fcte-pi1/2026.2_PI1_Grupo1_Lui/README.md

# Projeto Integrador 1 - 2026.2 | Grupo 01 | Prof. Lui

<div align="center">
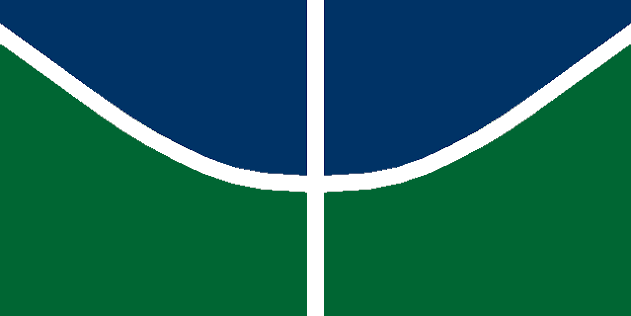
[picture p1: docs/images.png]
Logo UnB
  

  # Projeto Integrador 1 — Micromouse (Grupo 1)
  **Semestre 2026.2 | Universidade de Brasília (UnB) | Prof. Lui**

  
</div>

---

> **Aviso ao Professor:** Este é o repositório oficial do Grupo 01 utilizado para o desenvolvimento do projeto de PI1 (Micromouse) durante o semestre 2026.2. Todo o histórico de commits, código-fonte e detalhamentos estão centralizados aqui.

## 🤖 Sobre o Projeto
O projeto consiste no desenvolvimento completo de um robô autônomo (Micromouse) capaz de navegar e resolver um labirinto, integrando conhecimentos de quatro grandes áreas da engenharia: **Software, Eletrônica, Energia e Estruturas**.

Toda a documentação gerencial e conceitual (TAP, Requisitos, EAP, Cronograma, Testes, etc.) está centralizada de forma interativa no nosso **[Site de Documentação Oficial](https://fcte-pi1.github.io/2026.2_PI1_Grupo1_Lui/)**.

## 🗂️ Estrutura do Repositório
Para manter o padrão e a facilidade de busca, o repositório está dividido nas seguintes pastas:

* 📂 **`docs/`** — Arquivos Markdown (`.md`) e ativos que alimentam a página web.
* 📂 **`hw/`** — Arquitetura de hardware, esquemáticos e arquivos de simulação de circuitos.
* 📂 **`mec/`** — Modelagens 3D, arquivos CAD e projetos de estrutura.
* 📂 **`src/`** — Código-fonte e algoritmos de navegação/controle do robô.

*(A estrutura de pastas não isola as equipes. O projeto é multidisciplinar e os membros devem trabalhar nas diferentes pastas conforme a necessidade das tarefas).*

## 👥 Equipe
O time é formado por estudantes de engenharia e dividido em subáreas para facilitar o gerenciamento técnico, atuando sob a liderança geral de **Antônio Lucas** e apoio dos subgerentes:

* 💻 **Software:** Pedro Ian (Subgerente)
* ⚡ **Energia:** Rafaela Trajano (Subgerente)
* 🔌 **Eletrônica:** Leonardo Augusto (Subgerente)
* 🏗️ **Estruturas:** Carlos Henrique (Subgerente)

<details>
<summary><b>Clique aqui para ver a lista completa com os 19 integrantes</b></summary>

* Humberto Alencar (Aeroespacial)
* João Vitor Sales Ibiapina (Software)
* Eduardo Lobo Moreira (Software)
* Pedro Ian (Software)
* Breno Teixeira (Software)
* Rafaela Trajano Ruas (Energia)
* Lucas Oliveira de Paula (Software)
* Carlos Henrique de Paiva Muniz (Software)
* Mariana Solano de Brito Elias (Aeroespacial)
* Antônio José Magalhães Leão Júnior (Software)
* João Pedro Jaime (Software)
* Lucas Peixoto Rodrigues (Software)
* Daniel Almeida Frota (Software)
* Antônio Lucas De Araújo Lima (Software)
* Pedro Franco Cavalcanti Rêgo (Software)
* Alexandre Henrique Almeida Valadares Sousa (Software)
* Davi Sakai (Software)
* Gustavo Antônio (Software)
* Leonardo Augusto (Eletrônica)

</details>

## 🚀 Para os Integrantes: Como Contribuir

A organização e a correta utilização do repositório serão consideradas na avaliação do grupo. Dessa forma, é fundamental que **todos** utilizem o Git de forma alinhada com a estratégia da equipe.

### Fluxo de Trabalho
1. **Clone o repositório:** Após obter acesso (via convite no e-mail ou notificação), abra o terminal e clone o projeto:
   ```bash
   git clone [https://github.com/fcte-pi1/2026.2_PI1_Grupo1_Lui.git](https://github.com/fcte-pi1/2026.2_PI1_Grupo1_Lui.git)

![Calendário 2026/2](https://github.com/fcte-pi1/template/blob/main/docs/figs/Calendario.png?raw=true)
