fcte-pi1/2026.2_PI1_Grupo1_Lui/docs/evidencias/5.3.1.1/README.md

# Evidências: EAP 5.3.1.1 (Contrato de dados, estrutura do src e CI com cobertura)

| Evidência | Arquivo | Resultado |
|:---|:---|:---|
| CI do backend com cobertura (pytest-cov) | [ci_backend.png](ci_backend.png) | Aprovado, 101 testes, 100% de cobertura |
| CI do frontend com lint, cobertura e build | [ci_frontend.png](ci_frontend.png) | Aprovado, 25,7% de cobertura |
| CI do firmware com cobertura (gcovr) | [ci_firmware.png](ci_firmware.png) | Aprovado, robô 92,3% e gateway 97,4% de linhas |
| Checks do PR #160 | [checks_pr160.png](checks_pr160.png) | Três workflows aprovados |
