fcte-pi1/2026.2_PI1_Grupo1_Lui/docs/evidencias/5.1.1.2/hu09-sem-aviso-apos-chegada.png

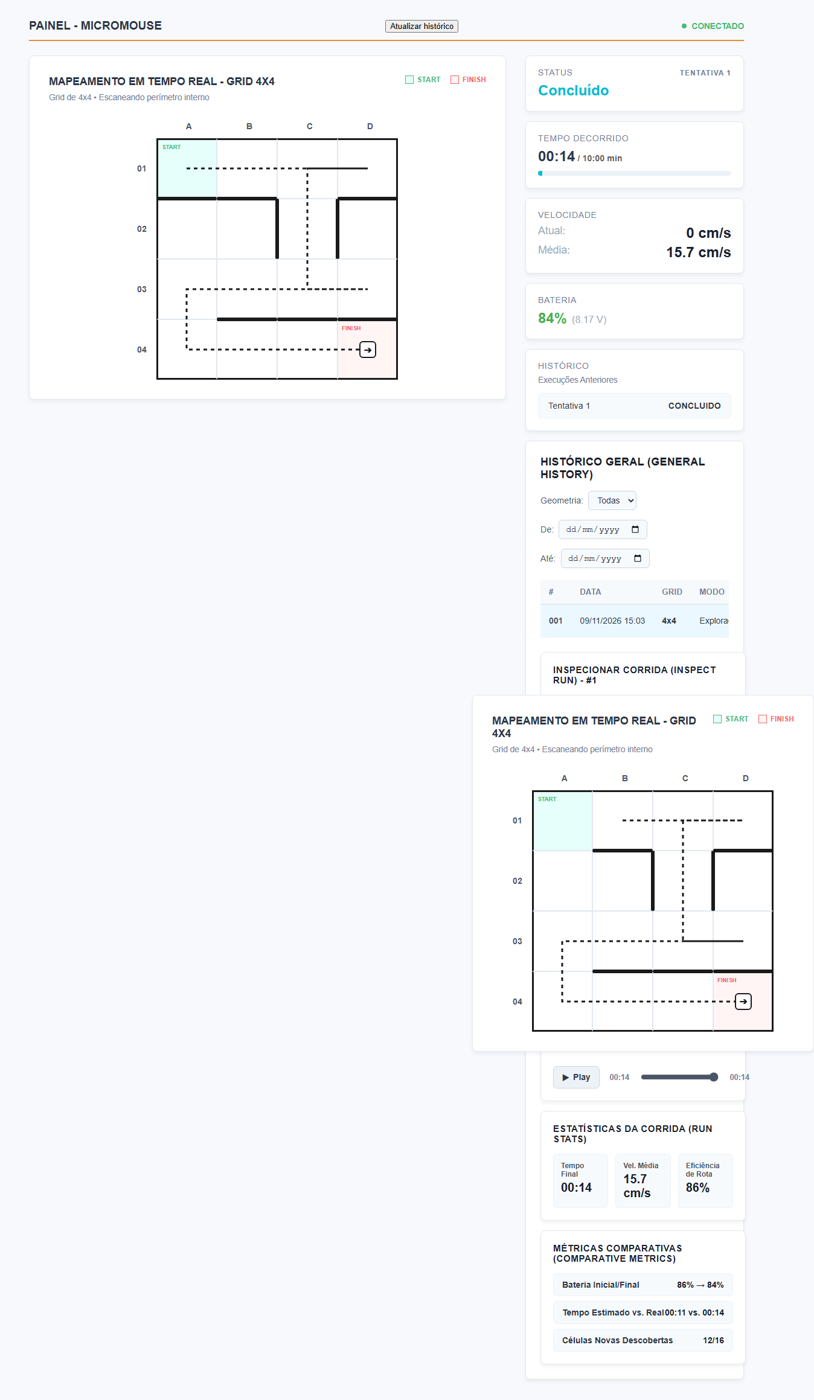
docs/evidencias/5.1.1.2/hu09-sem-aviso-apos-chegada.png
