fcte-pi1/2026.2_PI1_Grupo1_Lui/docs/evidencias/5.1.1.3/antes-firefox-1920x1080.png

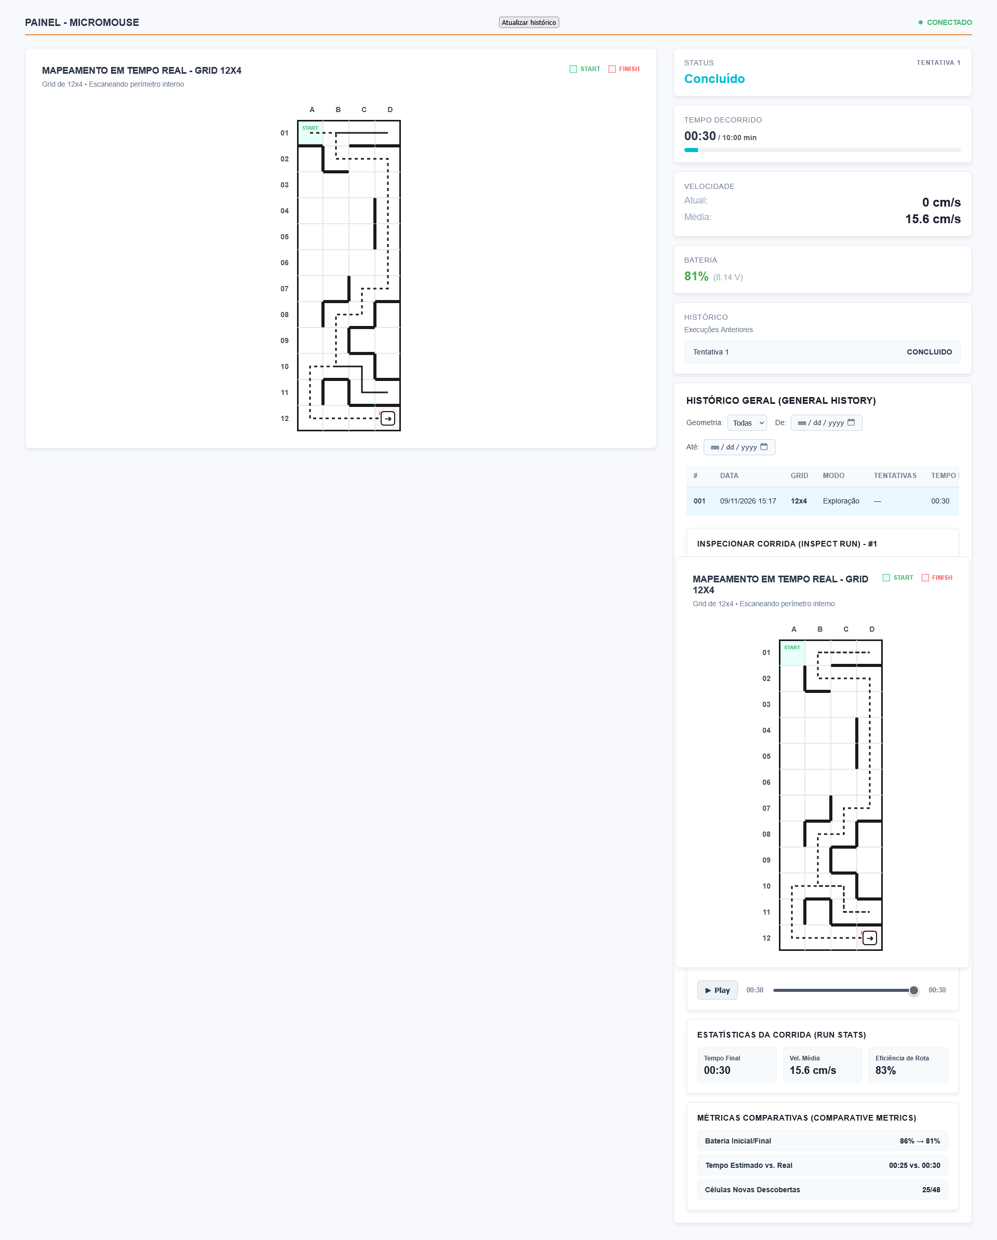
docs/evidencias/5.1.1.3/antes-firefox-1920x1080.png
