fcte-pi1/2026.2_PI1_Grupo1_Lui/docs/evidencias/5.1.1.4/antes-chromium-412x915-12x4.png

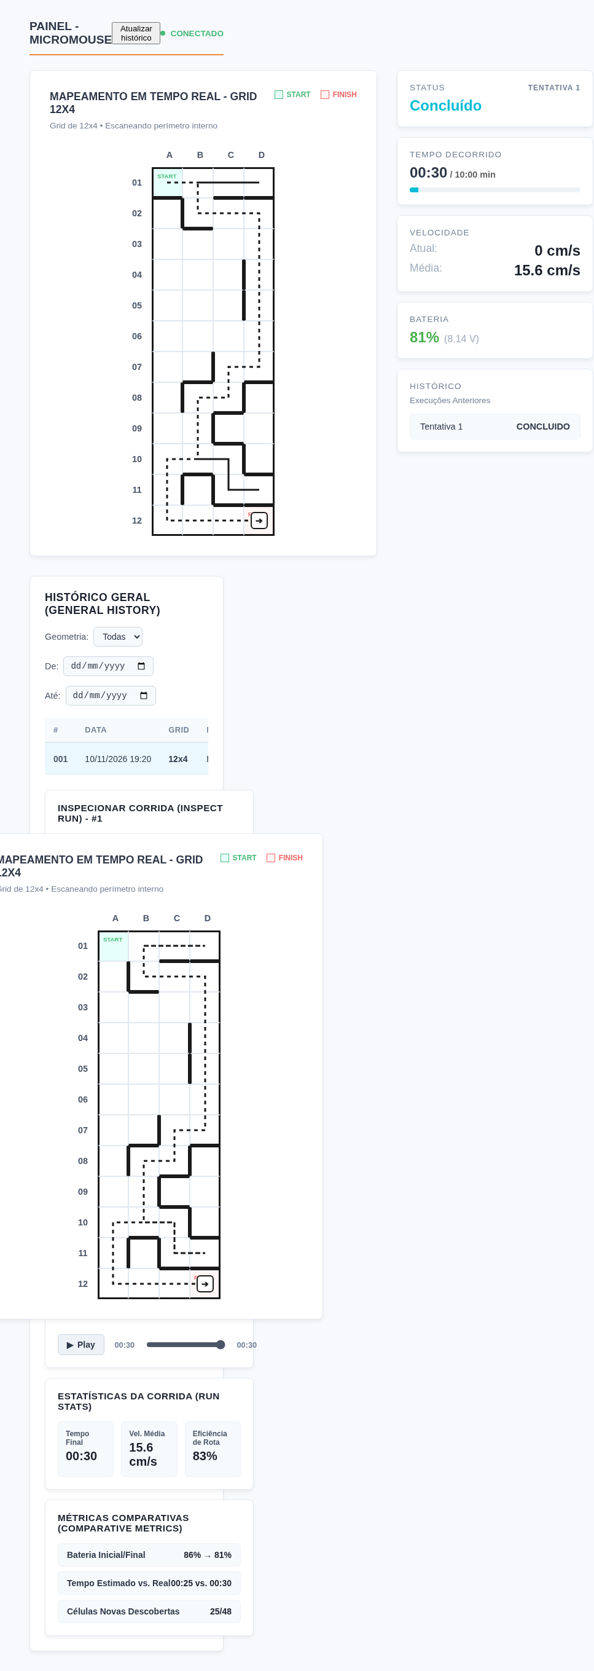
docs/evidencias/5.1.1.4/antes-chromium-412x915-12x4.png
