fcte-pi1/2026.2_PI1_Grupo1_Lui/docs/evidencias/5.1.2.1/medicao-tempo-resposta.png

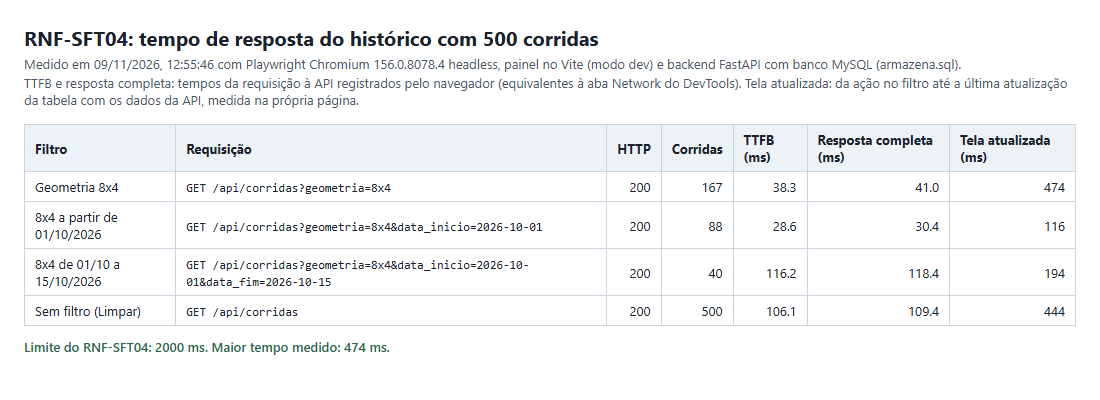
docs/evidencias/5.1.2.1/medicao-tempo-resposta.png
