fcte-pi1/2026.2_PI1_Grupo1_Lui/docs/evidencias/5.3.2.2/ci_execucao_firmware.png

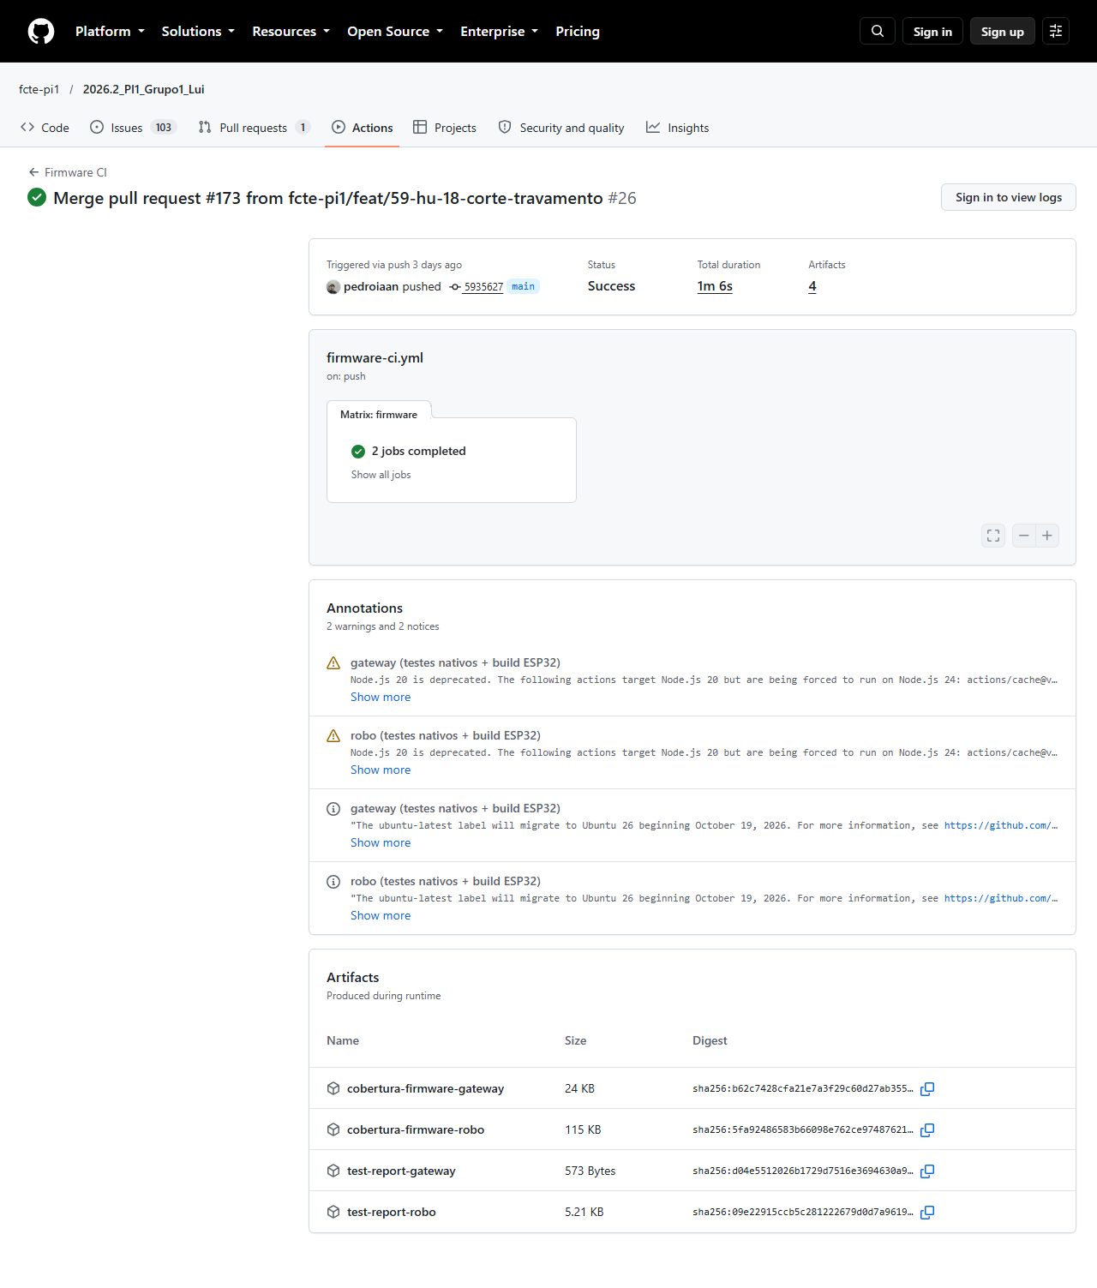
docs/evidencias/5.3.2.2/ci_execucao_firmware.png
