fcte-pi1/2026.2_PI1_Grupo1_Lui/docs/evidencias/5.3.2.2/cobertura_backend.png

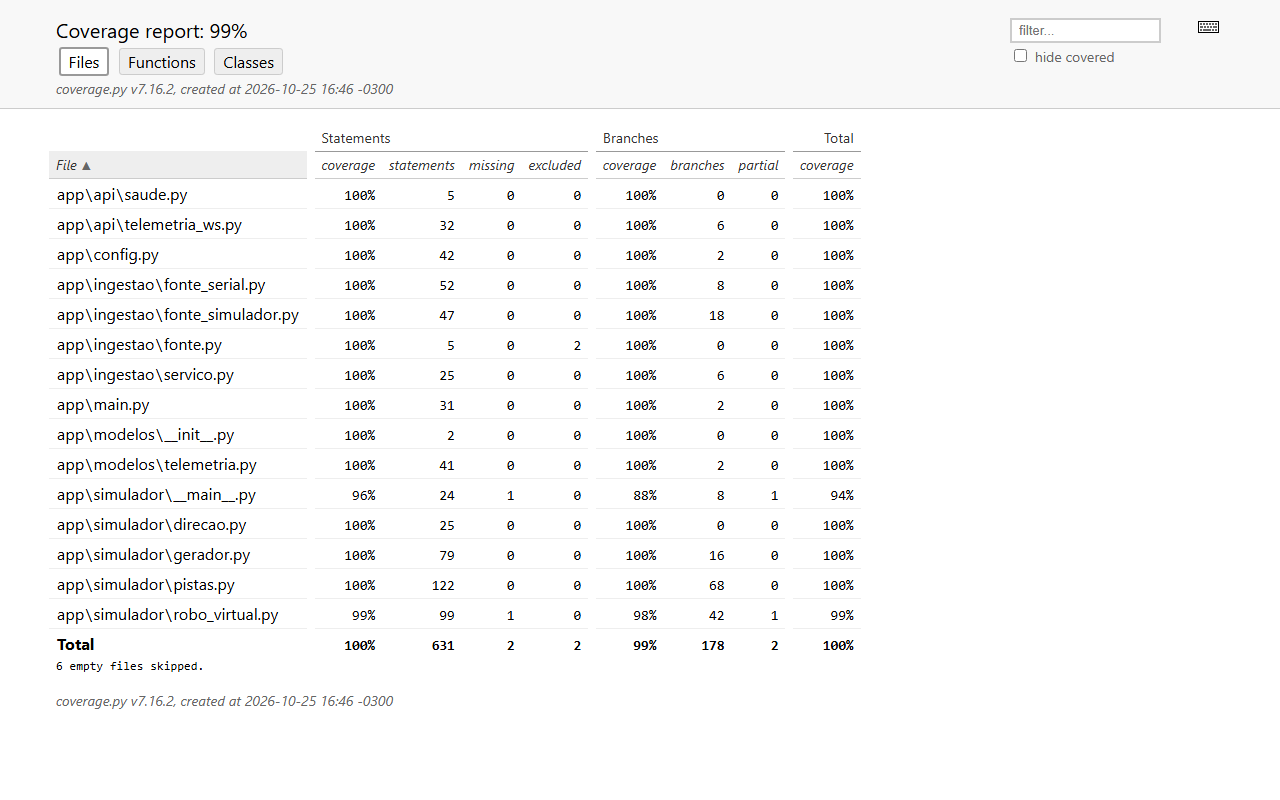
docs/evidencias/5.3.2.2/cobertura_backend.png
