fcte-pi1/2026.2_PI1_Grupo1_Lui/hw/testes/mms/default/README.md

# Algoritmo: DEFAULT (Versão Aprimorada - DFS)

Esta pasta mantém o nome original `DEFAULT` configurado no MMS, agora atualizado com o algoritmo de Busca em Profundidade com Retrocesso (DFS / Trémaux).

* **Arquivo principal:** `DEFAULT.py`
* **Interface do simulador:** `API.py`
* **Configuração no MMS:**
  * **Directory:** `/home/eduardolm/Downloads/MMS/DEFAULT`
  * **Run Command:** `python DEFAULT.py`
