fcte-pi1/2026.2_PI1_Grupo1_Lui/hw/testes/issue_140_telemetria_gateway/wokwi/circuito.png

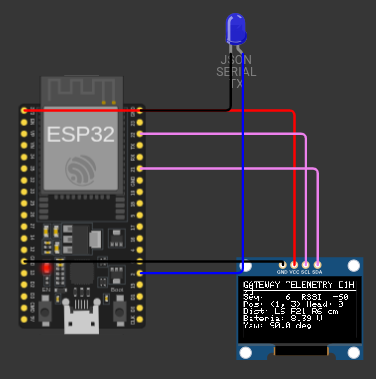
hw/testes/issue_140_telemetria_gateway/wokwi/circuito.png
