fcte-pi1/2026.2_PI1_Grupo1_Lui/docs/figs/micromouse_shield.pdf

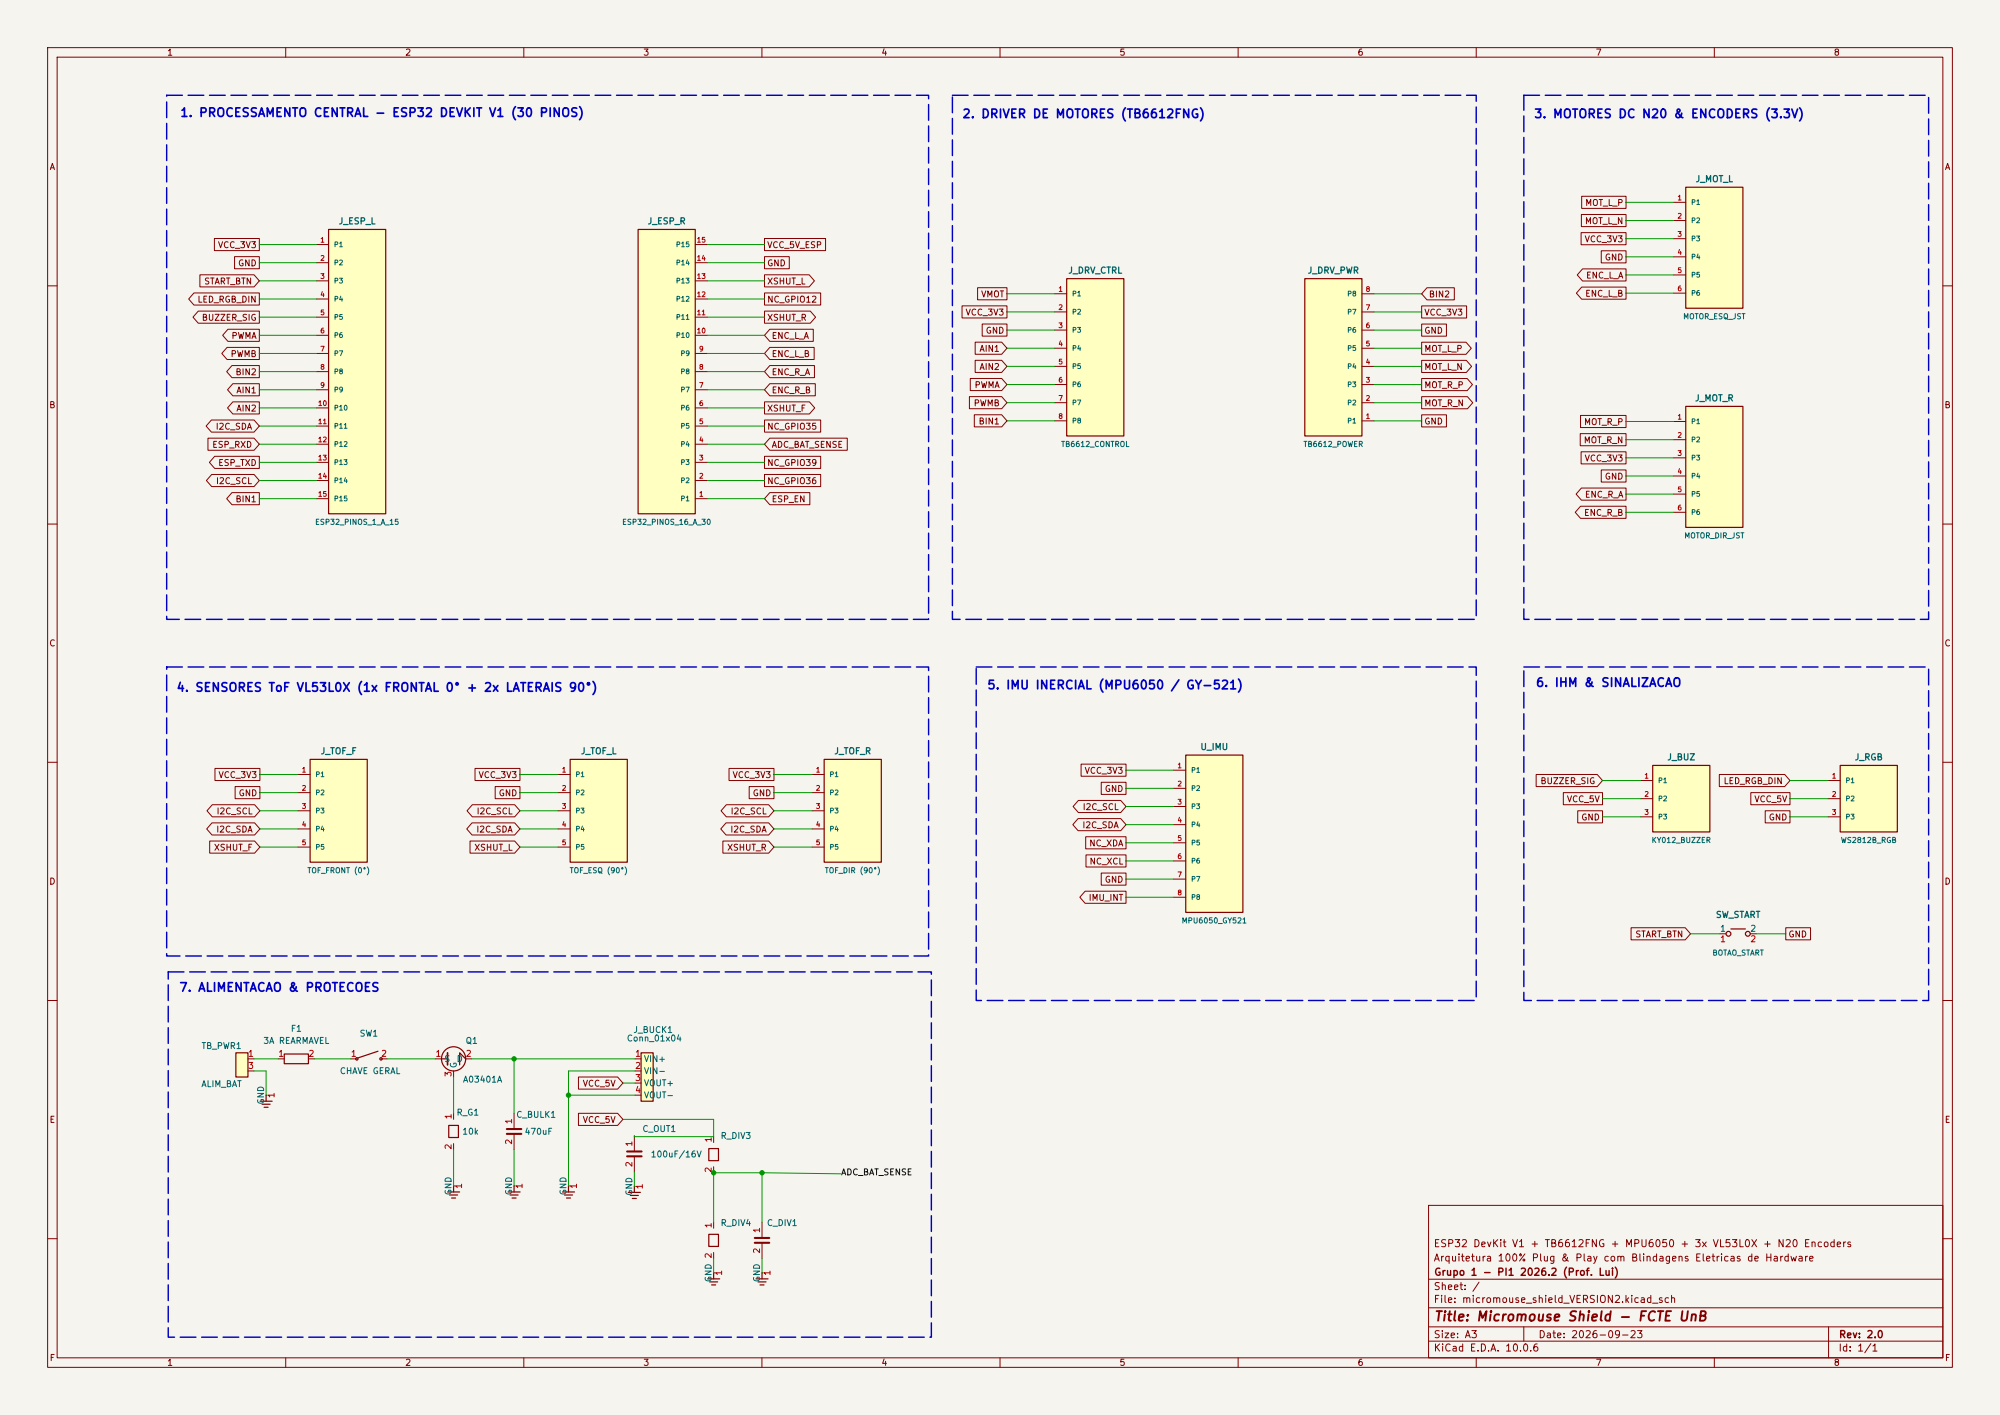
[picture p29: page 1]

Arquitetura 100% Plug & Play com Blindagens Eletricas de Hardware
Grupo 1 - PI1 2026.2 (Prof. Lui)
Sheet: /
File: micromouse_shield_VERSION2.kicad_sch
Title: Micromouse Shield - FCTE UnB

Size: A3 | Rev: 2.0 | F Date: 2026-09-23
KiCad E.D.A. 10.0.6 | Id: 1/1
