fcte-pi1/2026.2_PI1_Grupo1_Lui/hw/micromouse_shield/micromouse_shield.kicad_pcb

## KiCad design hw/micromouse_shield/micromouse_shield.kicad_pcb (2026-09-26)

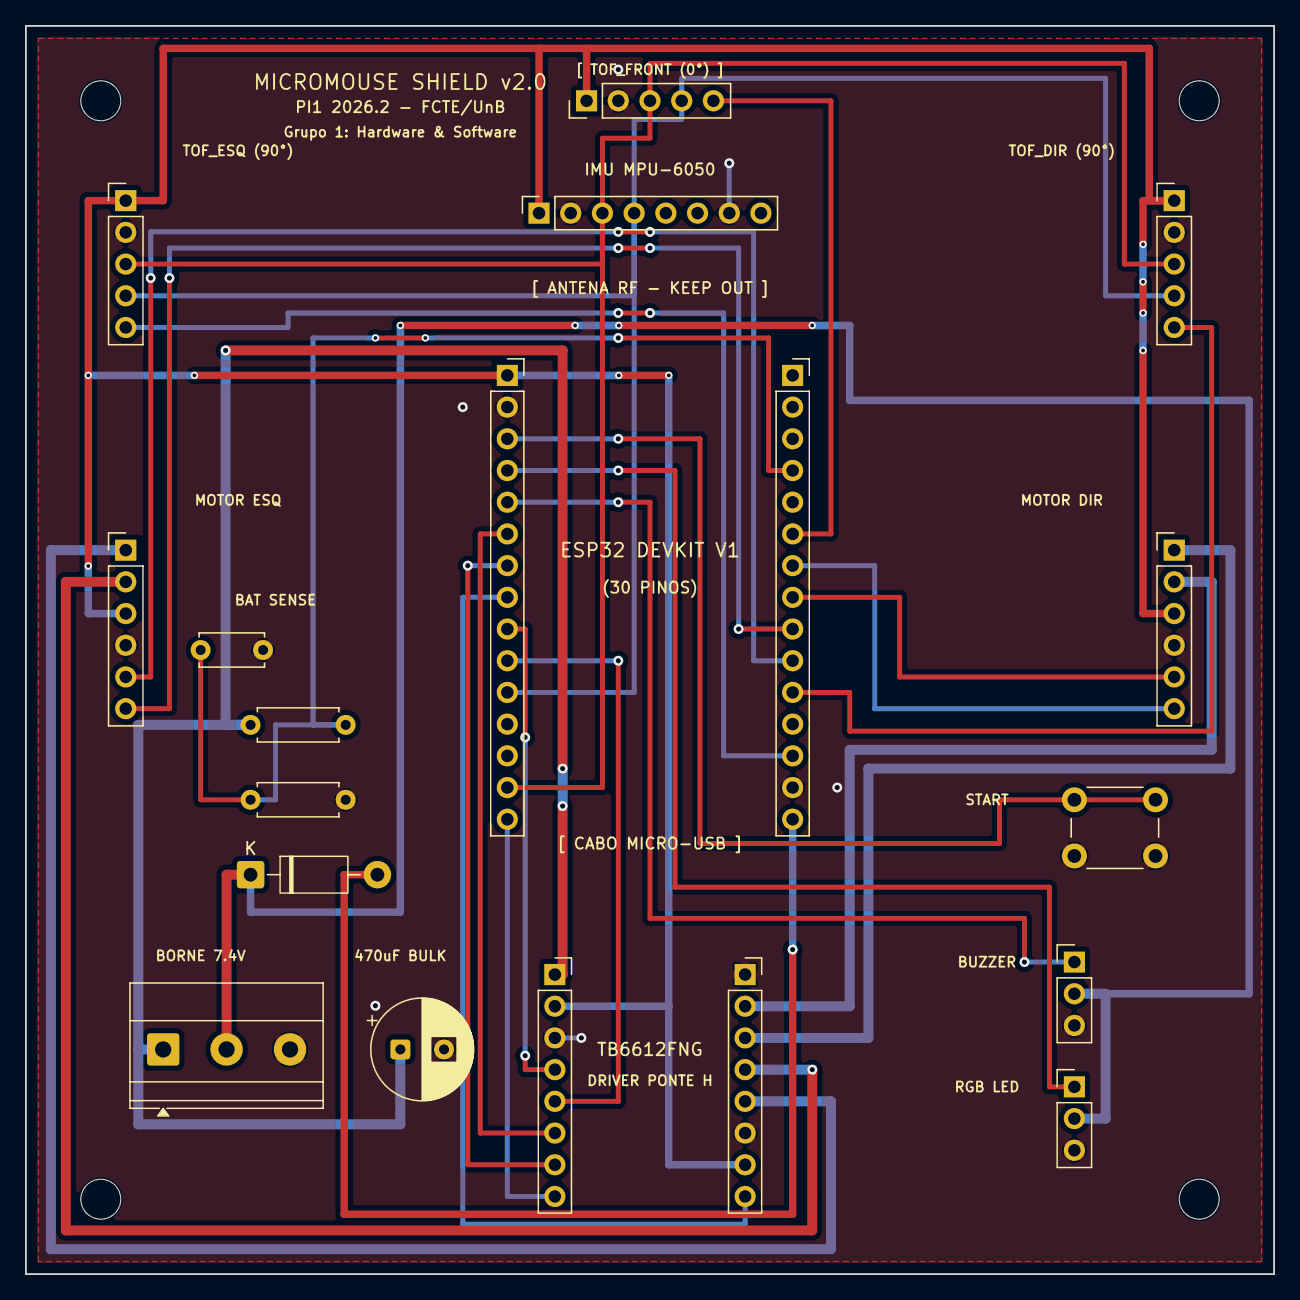
[picture p30: board micromouse_shield.kicad_pcb from above]

Board: 2 copper layers, 100.0 x 100.0 mm, 23 parts (0 on the bottom side), 28 nets.

Parts:
C_BULK: 470uF_16V; CP_Radial_D8.0mm_P3.50mm
C_DIV: 100nF; C_Disc_D5.0mm_W2.5mm_P5.00mm
D_USB_PROT: 1N5819; D_DO-41_SOD81_P10.16mm_Horizontal
H1, H2, H3, H4: M3; MountingHole_3.2mm_M3
J_BUZ: BUZZER; PinHeader_1x03_P2.54mm_Vertical
J_DRV_CTRL: TB6612_CTRL; PinSocket_1x08_P2.54mm_Vertical
J_DRV_PWR: TB6612_PWR; PinSocket_1x08_P2.54mm_Vertical
J_ESP_L: ESP32_LEFT; PinSocket_1x15_P2.54mm_Vertical
J_ESP_R: ESP32_RIGHT; PinSocket_1x15_P2.54mm_Vertical
J_MOT_L: MOTOR_ESQ; PinHeader_1x06_P2.54mm_Vertical
J_MOT_R: MOTOR_DIR; PinHeader_1x06_P2.54mm_Vertical
J_RGB: RGB_LED; PinHeader_1x03_P2.54mm_Vertical
J_TOF_F: TOF_FRONT; PinHeader_1x05_P2.54mm_Vertical
J_TOF_L: TOF_LEFT; PinHeader_1x05_P2.54mm_Vertical
J_TOF_R: TOF_RIGHT; PinHeader_1x05_P2.54mm_Vertical
R_DIV1: 100k; R_Axial_DIN0207_L6.3mm_D2.5mm_P7.62mm_Horizontal
R_DIV2: 33k; R_Axial_DIN0207_L6.3mm_D2.5mm_P7.62mm_Horizontal
SW_START: BOTAO_START; SW_PUSH_6mm
TB_PWR: BORNE_ALIM_7V4; TerminalBlock_Phoenix_MKDS-1,5-3-5.08_1x03_P5.08mm_Horizont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
U_IMU: MPU6050; PinSocket_1x08_P2.54mm_Vertical

Connections:
ADC_BAT_SENSE: C_DIV.1, J_ESP_R.4, R_DIV1.2, R_DIV2.1
AIN1: J_DRV_CTRL.4, J_ESP_L.9
AIN2: J_DRV_CTRL.5, J_ESP_L.10
BIN1: J_DRV_CTRL.8, J_ESP_L.15
BIN2: J_DRV_PWR.8, J_ESP_L.8
BUZZER_SIG: J_BUZ.1, J_ESP_L.5
ENC_L_A: J_ESP_R.10, J_MOT_L.5
ENC_L_B: J_ESP_R.9, J_MOT_L.6
ENC_R_A: J_ESP_R.8, J_MOT_R.5
ENC_R_B: J_ESP_R.7, J_MOT_R.6
GND: C_BULK.2, C_DIV.2, J_BUZ.3, J_DRV_CTRL.3, J_DRV_PWR.1, J_DRV_PWR.6, J_ESP_L.2, J_ESP_R.14, J_MOT_L.4, J_MOT_R.4, J_RGB.3, J_TOF_F.2, J_TOF_L.2, J_TOF_R.2, R_DIV2.2, SW_START.2, TB_PWR.3, U_IMU.2, U_IMU.7
I2C_SCL: J_ESP_L.14, J_TOF_F.3, J_TOF_L.3, J_TOF_R.3, U_IMU.3
I2C_SDA: J_ESP_L.11, J_TOF_F.4, J_TOF_L.4, J_TOF_R.4, U_IMU.4
LED_RGB_DIN: J_ESP_L.4, J_RGB.1
MOT_L_N: J_DRV_PWR.4, J_MOT_L.2
MOT_L_P: J_DRV_PWR.5, J_MOT_L.1
MOT_R_N: J_DRV_PWR.2, J_MOT_R.2
MOT_R_P: J_DRV_PWR.3, J_MOT_R.1
PWMA: J_DRV_CTRL.6, J_ESP_L.6
PWMB: J_DRV_CTRL.7, J_ESP_L.7
START_BTN: J_ESP_L.3, SW_START.1
VCC_3V3: J_DRV_CTRL.2, J_DRV_PWR.7, J_ESP_L.1, J_MOT_L.3, J_MOT_R.3, J_TOF_F.1, J_TOF_L.1, J_TOF_R.1, U_IMU.1
VCC_5V: D_USB_PROT.1, J_BUZ.2, J_RGB.2, TB_PWR.2
VCC_5V_ESP: D_USB_PROT.2, J_ESP_R.15
VMOT: C_BULK.1, J_DRV_CTRL.1, R_DIV1.1, TB_PWR.1
XSHUT_F: J_ESP_R.6, J_TOF_F.5
XSHUT_L: J_ESP_R.13, J_TOF_L.5
XSHUT_R: J_ESP_R.11, J_TOF_R.5
