fcte-pi1/2026.2_PI1_Grupo1_Lui/src/firmware/robo/src/hardware/Pinos.h

#ifndef PINOS_H
#define PINOS_H

#include <stdint.h>

// Configuração única do hardware do robô: pinos do ESP32 DevKit V1 (30 pinos) e
// constantes físicas. Sem dependência do Arduino, para os testes nativos poderem usar
// os mesmos valores do firmware.
//
// Fonte: firmware da Eletrônica que está gravado e funcionando no robô
// (hw/firm/include/pinout.h e hw/firm/README.md, branch
// feat/firmware-final-comissionamento-telemetria). A tabela de pinagem do doc 4.3 está
// desatualizada em relação a essa pinagem.
//
// Ao acrescentar um pino, inclua-o também em PINOS_EM_USO (o teste test_pinos confere
// que nenhum GPIO é usado duas vezes).

// --- Ponte H TB6612FNG (motor 1 = esquerdo, motor 2 = direito) ---
const uint8_t PINO_PONTE_PWMA = 25;  // PWM do motor esquerdo (20 kHz)
const uint8_t PINO_PONTE_AIN1 = 26;  // sentido do motor esquerdo
const uint8_t PINO_PONTE_AIN2 = 27;  // sentido do motor esquerdo
const uint8_t PINO_PONTE_STBY = 13;  // standby: HIGH habilita a ponte H
const uint8_t PINO_PONTE_BIN1 = 33;  // sentido do motor direito
const uint8_t PINO_PONTE_BIN2 = 32;  // sentido do motor direito
const uint8_t PINO_PONTE_PWMB = 18;  // PWM do motor direito (20 kHz)

// --- Encoders em quadratura ---
// Os GPIO 34 a 39 só funcionam como entrada e não têm pull-up interno.
const uint8_t PINO_ENCODER_ESQ_A = 36;  // VP
const uint8_t PINO_ENCODER_ESQ_B = 39;  // VN
const uint8_t PINO_ENCODER_DIR_A = 35;
const uint8_t PINO_ENCODER_DIR_B = 2;   // pino de boot do ESP32, com pull-up interno

// --- Sensores ToF VL53L0X (I2C compartilhado + XSHUT individual) ---
const uint8_t PINO_I2C_SDA = 21;
const uint8_t PINO_I2C_SCL = 22;
const uint8_t PINO_TOF_XSHUT_ESQ = 4;       // sensor 1, lateral esquerdo (0x30)
const uint8_t PINO_TOF_XSHUT_FRONTAL = 16;  // sensor 2, frontal (0x31)
const uint8_t PINO_TOF_XSHUT_DIR = 17;      // sensor 3, lateral direito (0x32)

// --- Interface e bateria ---
const uint8_t PINO_BOTAO = 15;  // botão de largada, com pull-up interno (nível LOW = pressionado)
// Provisório: depende de confirmação da Eletrônica. Na pinagem nova o GPIO 2 (antigo
// pino do LED) é o canal B do encoder direito; o README da Eletrônica indica o GPIO 14
// como "Status LED / reserva".
const uint8_t PINO_LED_ESTADO = 14;  // LED WS2812B de estado
const uint8_t PINO_BATERIA_ADC = 34;  // ADC1_CH6, ponto médio do divisor da bateria

const uint8_t PINOS_EM_USO[] = {
    PINO_PONTE_PWMA, PINO_PONTE_AIN1, PINO_PONTE_AIN2, PINO_PONTE_STBY,
    PINO_PONTE_BIN1, PINO_PONTE_BIN2, PINO_PONTE_PWMB,
    PINO_ENCODER_ESQ_A, PINO_ENCODER_ESQ_B, PINO_ENCODER_DIR_A, PINO_ENCODER_DIR_B,
    PINO_I2C_SDA, PINO_I2C_SCL,
    PINO_TOF_XSHUT_ESQ, PINO_TOF_XSHUT_FRONTAL, PINO_TOF_XSHUT_DIR,
    PINO_BOTAO, PINO_LED_ESTADO, PINO_BATERIA_ADC,
};
const uint8_t PINOS_EM_USO_QTD = sizeof(PINOS_EM_USO) / sizeof(PINOS_EM_USO[0]);

// --- Constantes físicas (confirmadas pela Eletrônica e Estruturas) ---
constexpr float RODA_DIAMETRO_MM = 22.0f;  // conforme doc 4.1 seção 7.1
// Pulsos por volta da RODA, contando só a borda de subida do canal A (como a ISR do
// hw/firm e a de drivers/Encoders.cpp).
const uint16_t ENCODER_PULSOS_POR_VOLTA = 360;  // 12 CPR x redução 30:1, segundo o hw/firm
constexpr float BITOLA_MM = 80.0f;              // distância entre os centros das rodas
// Deslocamento de uma roda por pulso: pi x 22 / 360, cerca de 0,192 mm.
constexpr float RODA_MM_POR_PULSO = 3.14159265f * RODA_DIAMETRO_MM / ENCODER_PULSOS_POR_VOLTA;

// Sentidos de montagem (achado R7). A lógica supõe que as duas contagens crescem e que
// PWM positivo leva a roda para a frente. Se na bancada (testes 2 e 3 do menu do hw/firm)
// uma roda girar ou contar ao contrário, troque o valor aqui; os drivers aplicam a
// inversão e o resto do firmware não muda.
const bool MOTOR_ESQ_INVERTIDO = false;
const bool MOTOR_DIR_INVERTIDO = false;
const bool ENCODER_ESQ_INVERTIDO = false;
const bool ENCODER_DIR_INVERTIDO = false;

// --- Ponte H: PWM do ESP32 (LEDC), como no hw/firm ---
const uint32_t PONTE_PWM_FREQ_HZ = 20000;  // acima da faixa audível
const uint8_t PONTE_PWM_BITS = 8;          // PWM de 0 a 255
const uint8_t PWM_MAXIMO = 255;  // resolução da ponte H; o freio ativo usa o máximo, como no hw/firm

// Conversão de velocidade em PWM (achado B6, controle/ConversorVelocidadePwm.h), em malha
// aberta: |PWM| = PWM_MINIMO + |v| x PWM_POR_MM_S, saturado em PWM_MAXIMO_MOVIMENTO.
// PWM_MINIMO vence a zona morta dos motores (10 a 15 % segundo o doc 4.3).
//
// Valores provisórios, partindo do hw/firm, que é o único código que já moveu o robô: os
// avanços e curvas dele usam PWM 90 (cerca de 35 %), então nenhum movimento passa de 90 até
// a rampa de PWM do roteiro de bancada (velocidade medida nos encoders em função do PWM,
// rodas no ar). A inclinação põe a velocidade base da reta (150 mm/s, ControleReta) em
// PWM 90: com o teto em 90, uma inclinação maior saturaria as duas rodas em toda a faixa
// da reta e o controle perderia a correção lateral. Depois da rampa, substituir os três
// valores pelos medidos.
const uint8_t PWM_MINIMO = 40;
const uint8_t PWM_MAXIMO_MOVIMENTO = 90;
constexpr float PWM_POR_MM_S = (float)(PWM_MAXIMO_MOVIMENTO - PWM_MINIMO) / 150.0f;  // cerca de 0,33

// --- Labirinto (regulamento) ---
// Passo entre centros de células: é o que o robô avança por célula e o que a velocidade
// média usa. O vão livre do corredor é o passo menos a espessura da parede (12 mm) e serve
// de referência para os limiares dos sensores de distância. O hw/firm usa 168 mm como
// "célula"; aqui o avanço é de centro a centro (docs/firmware/integracao-loop.md, R2).
constexpr uint16_t CELULA_MM = 180;
constexpr uint16_t VAO_CORREDOR_MM = 168;

// --- Sensores ToF VL53L0X ---
// Endereços I2C atribuídos no boot pela sequência dos XSHUT, como no hw/firm.
const uint8_t TOF_ENDERECO_ESQ = 0x30;
const uint8_t TOF_ENDERECO_FRONTAL = 0x31;
const uint8_t TOF_ENDERECO_DIR = 0x32;
const uint32_t TOF_I2C_HZ = 100000;          // 100 kHz, o do hw/firm (fiação com jumpers)
const uint32_t TOF_ORCAMENTO_US = 33000;     // orçamento de medição: cerca de 30 Hz por sensor
// A leitura não espera o sensor (achado B10): o driver consulta "amostra pronta" e, se um
// sensor ficar sem amostra nova por mais que TOF_VALIDADE_MS, a leitura dele passa a ser
// inválida. O timeout da biblioteca é só uma segunda barreira.
const uint16_t TOF_VALIDADE_MS = 100;
const uint16_t TOF_TIMEOUT_BIBLIOTECA_MS = 20;
const uint8_t TOF_PERIODO_CONSULTA_MS = 5;   // intervalo mínimo entre consultas ao barramento
// Erro de I2C (sensor solto ou barramento travado): cada transação espera no máximo
// TOF_I2C_TIMEOUT_MS e o sensor fica TOF_ESPERA_APOS_ERRO_MS sem ser consultado. No pior
// caso, cerca de 3 x 5 ms a cada 50 ms, longe de travar o laço.
const uint8_t TOF_I2C_TIMEOUT_MS = 5;
const uint8_t TOF_ESPERA_APOS_ERRO_MS = 50;
const uint16_t TOF_LEITURA_INVALIDA_MM = 8190;  // valor que o VL53L0X devolve sem alvo

// Distâncias frontais do avanço de uma célula (seção 3.5 do desenho).
// DIST_MINIMA_SEGURA_MM: limite de colisão do hw/firm; abaixo disso, antes de completar
// 60 % do avanço, o executor freia e desiste (emergência frontal, que vira COLISAO).
// DIST_ENCOSTO_FRONTAL_MM: com parede à frente, o avanço termina a esta distância dela,
// o que zera o erro longitudinal da odometria. Valor inicial pela geometria (robô
// centrado na célula), a calibrar na bancada com o robô parado no centro da célula.
const uint16_t DIST_MINIMA_SEGURA_MM = 30;
const uint16_t DIST_ENCOSTO_FRONTAL_MM = 45;

// Classificação de parede (achado R3, sensores/ClassificadorParedes.h). Com o robô
// centrado, a parede lateral fica a cerca de 40 mm do sensor e a ausência de parede mostra
// pelo menos 200 mm; qualquer limiar entre 90 e 150 mm funciona. 110 mm é o do hw/firm, a
// confirmar na bancada (teste 1 do menu). Há parede quando a distância cai abaixo de
// LIMIAR - HISTERESE e deixa de haver quando passa de LIMIAR + HISTERESE.
const uint16_t LIMIAR_PAREDE_MM = 110;
const uint16_t HISTERESE_PAREDE_MM = 5;

// --- LED de estado (achado R5) ---
// O firmware do robô usa um WS2812B; o hw/firm trata o GPIO 14 como LED comum. Confirmar
// com a Eletrônica qual está montado e ajustar aqui: drivers/SinalizacaoLed.cpp escolhe a
// variante (cores no WS2812B, padrões de piscada no LED comum).
enum TipoLedEstado : uint8_t {
    LED_WS2812B,
    LED_COMUM
};
const TipoLedEstado TIPO_LED_ESTADO = LED_WS2812B;

// Divisor de tensão da bateria (resistor em série com a bateria e resistor para o GND,
// com o ponto médio em PINO_BATERIA_ADC). Valores do firmware que roda no robô: módulo
// sensor de tensão comercial de 30 kΩ / 7,5 kΩ, proporção 5:1 (bateria cheia de 8,4 V
// dá 1,68 V no pino). Depende de confirmação da Eletrônica: o doc 4.3 indica
// 100 kΩ / 47 kΩ (proporção de cerca de 3,13:1).
const uint32_t BATERIA_R_SERIE_OHM = 30000;
const uint32_t BATERIA_R_GND_OHM = 7500;

// Tensão mínima para aceitar a largada (achado R4): 3,4 V por célula, o alarme de bateria
// do hw/firm. Durante a prova não há corte por bateria (seção 3.7 do desenho).
const uint16_t BATERIA_MINIMA_LARGADA_MV = 6800;

#endif
