fcte-pi1/2026.2_PI1_Grupo1_Lui/src/backend/tests/test_corridas.py

import asyncio
import time

from fastapi.testclient import TestClient

from app.main import criar_app
from app.modelos.telemetria import TelemetriaMensagem
from app.simulador.gerador import gerar_corrida
from app.simulador.pistas import pista_de_referencia


class Fonte:
    def __init__(self, itens):
        self.itens = itens

    async def mensagens(self):
        for item in self.itens:
            if isinstance(item, BaseException):
                raise item
            yield item


def pacotes(cenario="completa"):
    return [
        TelemetriaMensagem.model_validate_json(linha)
        for linha in gerar_corrida(pista_de_referencia("4x4"), cenario)
    ]


def aguardar_corridas(cliente, predicado):
    limite = time.monotonic() + 5
    corridas = []
    while time.monotonic() < limite:
        corridas = cliente.get("/api/corridas").json()
        if predicado(corridas):
            return corridas
        time.sleep(0.05)
    return corridas


def test_corrida_normal_e_travada_persistem_todas_as_leituras_e_consultam_api(url_banco):
    mensagens = pacotes("completa") + pacotes("travado")
    app = criar_app(Fonte(mensagens), database_url=url_banco)
    with TestClient(app) as cliente:
        corridas = aguardar_corridas(
            cliente, lambda itens: [c["status"] for c in itens] == ["TRAVADO", "CONCLUIDO"]
        )
        assert [c["status"] for c in corridas] == ["TRAVADO", "CONCLUIDO"]

        # O status final pode ficar visível na API antes da última transação
        # de leitura terminar de ser observável pela conexão do teste.
        time.sleep(0.1)
        limite = time.monotonic() + 5
        detalhes = None

        while time.monotonic() < limite:
            detalhes = cliente.get(f"/api/corridas/{corridas[-1]['id']}").json()
            if len(detalhes["leituras"]) == len(pacotes("completa")) - 4:
                break
            time.sleep(0.05)

        assert detalhes is not None
        # Sem as duas mensagens AGUARDANDO e as duas repetições do CONCLUIDO.
        assert len(detalhes["leituras"]) == len(pacotes("completa")) - 4
        assert detalhes["leituras"][-1]["status"] == "CONCLUIDO"
        assert set(detalhes["leituras"][-1]["paredes"]) == {"norte", "sul", "leste", "oeste"}
        assert corridas[-1]["tentativa"] is None

def test_corrida_ativa_tem_fim_e_status_final_nulos_e_modo_valido(url_banco):
    from app.servicos.corridas import ServicoCorridas

    app = criar_app(database_url=url_banco)
    with TestClient(app) as cliente:
        servico = ServicoCorridas(app.state.sessoes)
        servico.processar(pacotes()[2])
        corrida = cliente.get("/api/corridas").json()[0]
        assert corrida["status"] == "MAPEANDO"
        assert corrida["iniciada_em"].endswith("Z")
        assert corrida["encerrada_em"] is None
        assert corrida["modo"] == "EXPLORACAO"
        assert corrida["tentativa"] is None
        leitura = cliente.get(f"/api/corridas/{corrida['id']}").json()["leituras"][0]
        assert leitura["orientacao"] in {"NORTE", "SUL", "LESTE", "OESTE"}


def test_fim_inesperado_marca_corrida_interrompida_e_preserva_leituras(url_banco):
    # A fonte acaba no meio do percurso, ainda em MAPEANDO.
    mensagens = pacotes()[:8]
    assert mensagens[-1].status == "MAPEANDO"
    app = criar_app(Fonte(mensagens), database_url=url_banco)
    with TestClient(app) as cliente:
        corrida = aguardar_corridas(
            cliente, lambda itens: bool(itens and itens[0]["status"] == "INTERROMPIDA")
        )[0]
        assert corrida["status"] == "INTERROMPIDA"
        assert cliente.get(f"/api/corridas/{corrida['id']}").json()["leituras"]


def test_perda_de_telemetria_finaliza_corrida_ativa(url_banco):
    async def sem_fim():
        yield pacotes()[2]
        await asyncio.Event().wait()

    class FontePausada:
        mensagens = staticmethod(sem_fim)

    app = criar_app(FontePausada(), database_url=url_banco, timeout_telemetria_s=0.05)
    with TestClient(app) as cliente:
        corridas = aguardar_corridas(
            cliente, lambda itens: bool(itens and itens[0]["status"] == "INTERROMPIDA")
        )
        assert corridas, "Nenhuma corrida encontrada antes do tempo limite"
        assert corridas[0]["status"] == "INTERROMPIDA"
        assert cliente.get(f"/api/corridas/{corridas[0]['id']}").json()["leituras"]


def test_reinicio_marca_corrida_aberta_interrompida_e_consulta_registros(url_banco):
    url = url_banco
    primeira = criar_app(database_url=url)
    with TestClient(primeira):
        corrida = TelemetriaMensagem.model_validate_json(gerar_corrida(pista_de_referencia("4x4"))[2])
        from app.servicos.corridas import ServicoCorridas
        ServicoCorridas(primeira.state.sessoes).processar(corrida)

    segunda = criar_app(database_url=url)
    with TestClient(segunda) as cliente:
        dados = cliente.get("/api/corridas").json()
        assert dados[0]["status"] == "INTERROMPIDA"
        assert cliente.get(f"/api/corridas/{dados[0]['id']}").json()["leituras"]


def test_corrida_inexistente_retorna_404(url_banco):
    with TestClient(criar_app(database_url=url_banco)) as cliente:
        assert cliente.get("/api/corridas/999").status_code == 404


def test_filtrar_corridas_por_geometria_e_data(url_banco):
    from datetime import datetime
    from app.banco import Corrida, iniciar_esquema

    app = criar_app(database_url=url_banco)
    iniciar_esquema(app.state.engine, app.state.sessoes)

    # Popula com corridas em diferentes datas e geometrias
    with app.state.sessoes.begin() as sessao:
        c1 = Corrida(
            labirinto="4x4",
            inicio=datetime(2026, 10, 24, 10, 0, 0),
            fim=datetime(2026, 10, 24, 10, 2, 0),
            tempo_total_ms=120000,
            status_final="CONCLUIDO",
            modo="EXPLORACAO",
            desafio_cumprido=True,
        )
        c2 = Corrida(
            labirinto="8x4",
            inicio=datetime(2026, 10, 25, 14, 0, 0),
            fim=datetime(2026, 10, 25, 14, 5, 0),
            tempo_total_ms=300000,
            status_final="CONCLUIDO",
            modo="EXPLORACAO",
            desafio_cumprido=True,
        )
        c3 = Corrida(
            labirinto="8x4",
            inicio=datetime(2026, 10, 25, 16, 0, 0),
            fim=datetime(2026, 10, 25, 16, 1, 30),
            tempo_total_ms=90000,
            status_final="CONCLUIDO",
            modo="SPEED_RUN",
            desafio_cumprido=True,
        )
        c4 = Corrida(
            labirinto="12x4",
            inicio=datetime(2026, 10, 26, 9, 0, 0),
            fim=datetime(2026, 10, 26, 9, 8, 0),
            tempo_total_ms=480000,
            status_final="TRAVADO",
            modo="EXPLORACAO",
            desafio_cumprido=False,
        )
        sessao.add_all([c1, c2, c3, c4])

    with TestClient(app) as cliente:
        # Sem filtro retorna todas (4)
        todas = cliente.get("/api/corridas").json()
        assert len(todas) == 4

        # Filtro por geometria 8x4
        res_8x4 = cliente.get("/api/corridas?geometria=8x4").json()
        assert len(res_8x4) == 2
        assert all(c["geometria"] == "8x4" for c in res_8x4)

        # Filtro por geometria 4x4
        res_4x4 = cliente.get("/api/corridas?geometria=4x4").json()
        assert len(res_4x4) == 1
        assert res_4x4[0]["geometria"] == "4x4"

        # Filtro com "todas" não restringe
        res_todas = cliente.get("/api/corridas?geometria=todas").json()
        assert len(res_todas) == 4

        # Filtro por data específica
        res_data = cliente.get("/api/corridas?data=2026-10-25").json()
        assert len(res_data) == 2
        assert all(c["iniciada_em"].startswith("2026-10-25") for c in res_data)

        # Filtro por formato brasileiro
        res_data_br = cliente.get("/api/corridas?data=25/10/2026").json()
        assert len(res_data_br) == 2

        # Filtro por intervalo de datas
        res_intervalo = cliente.get("/api/corridas?data_inicio=2026-10-24&data_fim=2026-10-25").json()
        assert len(res_intervalo) == 3

        # Filtro combinado: geometria 8x4 e data 2026-10-25
        res_combinado = cliente.get("/api/corridas?geometria=8x4&data=2026-10-25").json()
        assert len(res_combinado) == 2

        # Filtro combinado sem correspondência: 4x4 na data 2026-10-25
        res_vazio = cliente.get("/api/corridas?geometria=4x4&data=2026-10-25").json()
        assert len(res_vazio) == 0


def test_performance_consulta_500_corridas(url_banco):
    """RNF-SFT04: Resposta inferior a 2,0 s para base com até 500 registros."""
    from datetime import datetime, timedelta
    from app.banco import Corrida, iniciar_esquema

    app = criar_app(database_url=url_banco)
    iniciar_esquema(app.state.engine, app.state.sessoes)

    geometrias = ["4x4", "8x4", "12x4"]
    corridas = []
    base_data = datetime(2026, 10, 1, 8, 0, 0)
    for i in range(500):
        corridas.append(
            Corrida(
                labirinto=geometrias[i % 3],
                inicio=base_data + timedelta(hours=i),
                fim=base_data + timedelta(hours=i, minutes=3),
                tempo_total_ms=180000,
                status_final="CONCLUIDO" if i % 2 == 0 else "TRAVADO",
                modo="EXPLORACAO",
                desafio_cumprido=i % 2 == 0,
            )
        )

    with app.state.sessoes.begin() as sessao:
        sessao.add_all(corridas)

    with TestClient(app) as cliente:
        inicio = time.monotonic()
        resposta = cliente.get("/api/corridas?geometria=8x4&data_inicio=2026-10-05&data_fim=2026-10-15")
        duracao = time.monotonic() - inicio

        assert resposta.status_code == 200
        dados = resposta.json()
        assert len(dados) > 0
        assert duracao < 2.0  # RNF-SFT04 estrito (< 2s)



def test_orientacoes_e_geometrias_do_contrato_voltam_iguais_da_api(url_banco, mensagem):
    """#142: a orientação é gravada com o nome do contrato, igual ao ENUM do armazena.sql."""
    from app.servicos.corridas import ServicoCorridas

    orientacoes = ["NORTE", "SUL", "LESTE", "OESTE"]
    app = criar_app(database_url=url_banco)
    with TestClient(app) as cliente:
        servico = ServicoCorridas(app.state.sessoes)
        for labirinto in ("4x4", "8x4", "12x4"):
            for i, orientacao in enumerate(orientacoes, start=1):
                dados = {
                    **mensagem, "labirinto": labirinto, "orientacao": orientacao,
                    "timestamp_ms": 1000 * i, "seq": i, "rssi": -60,
                }
                servico.processar(TelemetriaMensagem.model_validate(dados))

        corridas = cliente.get("/api/corridas").json()
        assert [c["labirinto"] for c in corridas] == ["12x4", "8x4", "4x4"]
        for corrida in corridas:
            leituras = cliente.get(f"/api/corridas/{corrida['id']}").json()["leituras"]
            assert [leitura["orientacao"] for leitura in leituras] == orientacoes
            assert {leitura["labirinto"] for leitura in leituras} == {corrida["labirinto"]}
            assert [leitura["seq"] for leitura in leituras] == [1, 2, 3, 4]


def test_banco_recusa_orientacao_fora_do_contrato(url_banco):
    """A abreviação que causou a #142 é recusada também no SQLite (CHECK do ENUM)."""
    import pytest
    from sqlalchemy.exc import DBAPIError

    from app.banco import Corrida, Leitura, iniciar_esquema

    app = criar_app(database_url=url_banco)
    iniciar_esquema(app.state.engine, app.state.sessoes)
    with app.state.sessoes.begin() as sessao:
        corrida = Corrida(labirinto="4x4")
        sessao.add(corrida)
    with pytest.raises(DBAPIError):
        with app.state.sessoes.begin() as sessao:
            sessao.add(Leitura(
                timestamp_ms=1000, labirinto="4x4", desafio_cumprido=False,
                bateria_pct=80, bateria_volts=7.4, corrida_id=corrida.id,
                velocidade_media=0, coluna="A", linha=1, orientacao="N",
                status="MAPEANDO", velocidade_atual=0,
            ))


def test_api_libera_cors_para_o_painel(monkeypatch):
    """O painel (Vite, outra porta) só lê /api/corridas se a resposta tiver CORS."""
    with TestClient(criar_app(database_url="sqlite://")) as cliente:
        resposta = cliente.get("/api/corridas", headers={"Origin": "http://localhost:5173"})
        assert resposta.headers["access-control-allow-origin"] == "*"

    monkeypatch.setenv("CORS_ORIGENS", "http://painel.local:5173, http://outro:4173")
    with TestClient(criar_app(database_url="sqlite://")) as cliente:
        liberada = cliente.get("/api/corridas", headers={"Origin": "http://painel.local:5173"})
        assert liberada.headers["access-control-allow-origin"] == "http://painel.local:5173"
        bloqueada = cliente.get("/api/corridas", headers={"Origin": "http://intruso:1234"})
        assert "access-control-allow-origin" not in bloqueada.headers


def test_repeticoes_do_pacote_terminal_nao_viram_leituras_nem_corrida_nova(url_banco):
    """HU-09: parado, o robô repete o pacote terminal a 1 Hz; só o primeiro é gravado."""
    from app.servicos.corridas import ServicoCorridas

    corrida = pacotes()
    app = criar_app(database_url=url_banco)
    with TestClient(app) as cliente:
        servico = ServicoCorridas(app.state.sessoes)
        for mensagem in corrida + [corrida[-1]] * 10:
            servico.processar(mensagem)

        corridas = cliente.get("/api/corridas").json()
        assert [c["status"] for c in corridas] == ["CONCLUIDO"]
        leituras = cliente.get(f"/api/corridas/{corridas[0]['id']}").json()["leituras"]
        assert len(leituras) == len(corrida) - 4
        assert [leitura["status"] for leitura in leituras].count("CONCLUIDO") == 1


def test_perda_temporaria_de_pacotes_mantem_uma_corrida_concluida(url_banco):
    """HU-09: os pacotes perdidos do perda_conexao não interrompem a corrida."""
    mensagens = pacotes("perda_conexao")
    app = criar_app(Fonte(mensagens), database_url=url_banco)
    with TestClient(app) as cliente:
        corridas = aguardar_corridas(
            cliente, lambda itens: bool(itens and itens[0]["status"] == "CONCLUIDO")
        )
        assert [c["status"] for c in corridas] == ["CONCLUIDO"]
        limite = time.monotonic() + 5
        while time.monotonic() < limite:
            leituras = cliente.get(f"/api/corridas/{corridas[0]['id']}").json()["leituras"]
            if len(leituras) == len(mensagens) - 4:
                break
            time.sleep(0.05)
        tempos = [leitura["timestamp_ms"] for leitura in leituras]
        assert len(leituras) == len(mensagens) - 4
        assert max(b - a for a, b in zip(tempos, tempos[1:])) > 1000  # a lacuna
