fcte-pi1/2026.2_PI1_Grupo1_Lui/(commit log)

2026-09-08 docs: adiciona termo de abertura do projeto
    Closes #1
2026-09-11 Upload do documento de requisitos
2026-09-11 docs: configuração inicial do site com MkDocs e GitHub Pages (#6)
    * docs: configura tema e navegacao do site
    * docs: adiciona dependencias do site
    * ci: adiciona workflow para deploy automatico do site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
2026-09-11 Logo Unb
    logo un para o git-pages
2026-09-11 docs: versão atualizada e final documento de requisitos
2026-09-11 docs: atualiza requisitos de acordo com feedbacks
2026-09-15 docs: refatora EAP com base nos feedbacks multidisciplinares
    - Limita aprofundamento aos pacotes de trabalho e épicos
    - Reestrutura subsistema de energia (4.1 a 4.6 com chave geral e monitoramento)
    - Decompõe interface web e adiciona simulador do labirinto e testes de software
    - Remove visualização estática em SVG e árvore textual redundante
2026-09-16 docs: refina ordem lógica, pacotes de trabalho e rastreabilidade da EAP
    - Corrige sequência cronológica do chassi (especificação -> CAD -> tração -> FEA -> fabricação -> montagem/fit test -> ensaios)
    - Elimina duplicidades e delimita escopos MECE entre 1.5, 2.1.1, 2.1.4, 2.1.7, 4.5 e 6.1
    - Estrutura Eletrônica/Hardware: adiciona 3.1.4 Interface de Usuário e Sinalização (IHM - LEDs de status RF-ELE05, buzzer RF-ELE06 e botões de largada física)
    - Refina 3.1.3 para contemplar Esquemático Elétrico e Diagrama de Blocos (conforme documento 4.3 de Hardware)
    - Adiciona validação dimensional metrológica do labirinto (corredores de 168 mm)
    - Incorpora pacotes formais de testes par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
2026-09-22 docs(#25): adiciona o primeiro esboço do painel de telemetria dos 3 labirintos.
2026-09-23 adição do primeiro esquema de tabelas para o db
2026-09-23 docs(#18): adiciona diagramas do Projeto conceitual de energia (arquivo 4.2)
2026-09-23 docs(#19): adiciona projeto preliminar conceitual de energia no arquivo 4.2
2026-09-23 chore: ignora artefatos locais de Python e MkDocs
2026-09-23 fix: arruma rotas para imagens dos diagramas
2026-09-23 modificação do esquema de tabelas db
2026-09-24 [AP5] Projeto Conceitual de Software (Arquivo 4.4)
    Adiciona diagrama de atividades do robô, mockup do web dashboard e a modelagem do banco de dados (MER).
2026-09-24 docs: adiciona projeto conceitual dos topicos 3 e 4 (controle de movimento e stall)
2026-09-24 docs(#24): estrutura base do 4.4 e secao de visao geral
2026-09-24 docs: adição protótipo histórico de corridas
2026-09-24 docs: adição da parte da lógica de comunicação
2026-09-25 docs(#24): remove arquivo avulso migrado para o 4.4
2026-09-25 docs(#30): adiciona roteiro de testes funcionais e revisão final do projeto conceitual de software
2026-09-26 docs: estrutura inicial do documento com sistema de tração e rodagem
2026-09-26 docs(hardware): adiciona projeto conceitual de hardware completo e shield kicad
    [micromouse_shield.kicad_pcb, micromouse_shield.kicad_sch]
2026-09-26 docs(hardware): remove secao de delimitacao de escopo com energia
2026-09-27 docs(estruturas): completar projeto conceitual do chassi e sistema de tração
2026-09-27 fix: restaura versao da main para resolver conflito no doc 4.4
2026-09-28 docs(#72): adiciona tabela detalhada de orcamento para o AP6 (#73)
2026-09-30 Revise orçamento com novos valores e notas
    Atualiza valores de itens do orçamento e adiciona notas sobre cotações.
2026-10-01 [HU-04] Selecionar a geometria da pista antes da largada
    - Criação da estrutura base do firmware do robô utilizando PlatformIO.
    - Implementação da struct TelemetriaPacket com as configurações de geometria do labirinto (4x4, 8x4 e 12x4).
    - Implementação da classe Mapa com redimensionamento dinâmico da matriz baseada na geometria selecionada.
    - Adição da lógica em main.cpp para alternar a configuração da pista via botão antes da largada.
    - Configuração do ambiente native no platformio.ini e criação de testes unitários nativos com Unity.
2026-10-01 chore: remove artefatos de build do PlatformIO
2026-10-01 fix(firmware): alinhar TelemetriaPacket, detecção de borda no botão, feedback visual no LED e refatorações
    [TelemetriaPacket.h, main.cpp]
2026-10-06 feat(frontend): implementa HU-11 acompanhamento de indicadores da prova #47
2026-10-07 feat(frontend): implementa prototipo visual do labirinto
    - Cria componente Labirinto com suporte dinâmico para grids 4x4, 8x4 e 12x4
    - Implementa renderização em tempo real simulada (paredes e trajeto SVG mockados)
    - Refatora layout do Painel para modo claro e exibição lado a lado (para ficar de acordo com o protótipo)
    - Adiciona botões para alternar a geometria da pista no painel
2026-10-09 fix(firmware): implementa toque triplo para selecao de geometria e LED NeoPixel WS2812B
    [main.cpp]
2026-10-09 fix(firmware): ajusta gestos do botão, debounce de 25ms, ignora pressão longa e alinha cores do LED com a seção 4.3
    [main.cpp]
2026-10-12 feat(firmware): telemetria ESP-NOW a 1 Hz e gateway com JSON na serial (#140)
    - lib/telemetria: pacote de 18 bytes, codec little-endian, validacao, JSON (ArduinoJson) com seq e rssi, GatewayBridge e temporizador 1 Hz
    - robo: envio ESP-NOW broadcast a 1 Hz
    - gateway: novo firmware ESP32 (ESP-NOW RX -> JSON na serial 115200)
    - testes nativos (Unity) e workflow firmware-ci.yml
    - docs: README do gateway com roteiro do teste de enlace e logs de evidencia
2026-10-12 docs(#140): evidencias de testes e builds do gateway/telemetria
2026-10-13 feat(backend): esqueleto FastAPI com schema da telemetria, /health e /ws/telemetria (#139)
    Estrutura de app/ conforme a seção 4.4 do doc 4.4. O schema Pydantic valida a mensagem do contrato (tipos estritos, linha limitada pela geometria, seq e rssi opcionais) e ignora campos desconhecidos. O WebSocket difunde para todos os clientes e remove quem falhar no envio. Ingestão serial, banco e watchdog ficam para outras issues.
2026-10-13 ci: cobertura dos testes nativos do firmware com gcovr (#139)
    O env native passa a compilar com --coverage -lgcov; o env esp32dev não muda.
2026-10-13 docs(#139): documenta o contrato de dados congelado em src/README.md
    Pacote de 18 bytes, linha JSON da serial, mensagem do WebSocket, dicionário de dados e regra de revisão para mudanças. Corrige o exemplo do README do gateway: o ArduinoJson escreve 35.0 como 35.
2026-10-14 feat(firmware): constantes de direção e parede coerentes com o contrato (#35)
    Enum Direcao com os valores do campo orientacao, máscaras de parede do campo paredes e funções de giro, direção oposta, conversão do lado do robô para direção absoluta e deslocamento na grade.
2026-10-14 feat(firmware): registro de paredes, perímetro e células visitadas no Mapa (#35)
    O perímetro é registrado ao definir a geometria. Paredes e passagens são gravadas também na célula vizinha, e uma matriz separada guarda os lados já conhecidos. Leituras de frente, esquerda e direita são convertidas para direções absolutas, e registrarMovimento marca a passagem atravessada e visita a célula de destino. getParedes devolve o byte do campo paredes da telemetria.
2026-10-14 test(firmware): testes do mapa, das direções e de percurso simulado em 4x4 (#35)
    Cobre perímetro nas três geometrias, simetria nas quatro direções, limites da grade, conversão relativa para absoluta, registro de movimento, o exemplo da seção 5.1 e um percurso simulado cujo mapa final é comparado com uma pista conhecida.
2026-10-14 feat(firmware): classe Botao com debounce, contagem de toques e largada ao soltar após 2 s (#38)
    Extrai do main.cpp a lógica do botão para uma classe sem dependência do Arduino, mantendo o debounce de 25 ms, a janela de toques de 400 ms e o limite de 1 s para toque. Soltar depois de pelo menos 2 s pressionado gera o evento de largada; pressões entre 1 s e 2 s são ignoradas.
2026-10-14 feat(firmware): largada por botão com transição para MAPEANDO e timestamp da prova (#38)
    Em AGUARDANDO, a largada inicia o cronômetro e muda o estado para MAPEANDO; o toque triplo continua alternando a geometria, agora só em AGUARDANDO. O timestamp_ms da telemetria passa a ser o tempo desde a largada (0 antes dela). O LED fica branco quando o botão completa 2 s pressionado, indicando que pode soltar.
2026-10-14 feat(backend): pistas de referência dos slides e robô virtual com flood fill (#141)
    As três pistas de exemplo dos slides ficam desenhadas em texto em pistas.txt e são validadas ao carregar: perímetro fechado, largada em A1 num beco aberto só para o leste e chegada alcançável, aceitando regiões fechadas. O robô virtual só sente frente, esquerda e direita, registra o lado de entrada como passagem e escolhe o caminho com flood fill sobre o próprio mapa.
2026-10-14 feat(backend): gerador de telemetria idêntica à do gateway e cenários do simulador (#141)
    Cada mensagem é montada nas unidades do pacote binário e convertida com as regras de TelemetriaJson.h, incluindo a ordem dos campos e a escrita de decimais inteiros. Cenários de corrida completa, travada no meio do percurso e com perda de conexão, nas três geometrias. O simulador também roda pela linha de comando com python -m app.simulador.
2026-10-14 feat(backend): fontes de telemetria intercambiáveis com difusão no WebSocket (#141)
    FonteSerial lê as linhas do gateway a 115200 bps com o pyserial, descarta linhas inválidas e de debug e reabre a porta se ela cair. FonteSimulador reproduz a corrida simulada a 1 mensagem por segundo, com fator de velocidade. A fonte é escolhida por TELEMETRIA_FONTE (nenhuma por padrão), e cada mensagem válida é difundida pelo GerenciadorConexoes.
2026-10-14 test(backend): testes do simulador, das fontes de telemetria e de ponta a ponta (#141)
2026-10-14 docs(#141): README do backend com as fontes de telemetria e o simulador
2026-10-15 feat(frontend): alinha labirinto ao contrato 6.4 e desacopla historico
    - Implementa funcao pura aplicarPacote(estado, pacote) consumindo contrato da secao 6.4
    - Atualiza simulacao com mensagens coerentes contendo paredes da celula atual
    - Remove fallback de mock no componente Labirinto (renderiza apenas perimetro sem dados)
    - Extrai componente HistoricoCorridas recebendo dados por props com estado vazio
    - Torna o indicador de conexao neutro enquanto nao integrado a HU-09
    - Adiciona testes unitarios para aplicarPacote, Labirinto e HistoricoCorridas
    Closes #46
2026-10-16 feat(#41): para a tração e conclui a prova ao chegar no objetivo (HU-07)
2026-10-17 fix(frontend): corrida nova decidida em painelTelemetria, sem apagar a largada (#141)
    aplicarPacote recriava o mapa só na transição de AGUARDANDO para MAPEANDO: a corrida seguinte era desenhada por cima da anterior até sair da largada, e o reinício apagava as paredes de A1 e o início do rastro. A decisão passa para iniciaNovaCorrida (AGUARDANDO depois de outro status, troca de geometria ou tempo voltando), e reduzirTelemetria aplica cada pacote sobre o mapa da corrida atual.
2026-10-17 feat(frontend): useTelemetria chama aoReceber para cada pacote (#141)
    O pacote devolvido pelo hook é só o mais recente, e pacotes que chegam juntos podem ser reunidos num único render. Com aoReceber, quem acumula dados recebe todos, na ordem.
2026-10-17 feat(frontend): painel ligado ao WebSocket de telemetria com indicador de conexão (#141)
    O mapa e os indicadores da HU-11 passam a vir do /ws/telemetria, e o indicador mostra CONECTADO ou DESCONECTADO. Saem os Controles de Simulação e a sequência mockada, substituídos pelo simulador do backend.
2026-10-17 docs(#141): passo a passo para rodar o sistema com o simulador
2026-10-17 fix(backend): simulador espera na largada até haver um painel conectado (#141)
    A corrida simulada começava assim que o backend subia, e o painel, que leva alguns segundos para conectar ou reconectar, perdia a largada e as primeiras células da primeira corrida. Como o robô real em AGUARDANDO, o simulador agora repete a mensagem de espera em A1 até haver um cliente no /ws/telemetria e só então dá a largada. O seq passa a ser numerado no envio. A fonte serial não muda.
2026-10-17 test(backend): simulador não difunde a corrida antes de haver painel (#141)
2026-10-17 docs(#134): alinha hardware com comunicacao ESP-NOW (BOM e OTA)
2026-10-18 feat(#32): controle de retas com PD nas paredes e rumo pelo IMU (HU-01)
2026-10-18 test(#32): testes nativos do controle de retas e simulação de 3 células
2026-10-18 docs(#32): registra o controle de retas no doc 4.4
2026-10-19 feat(firmware): congelar() no Cronometro (#41)
    Ao chegar no objetivo (HU-07), congelar(agoraMs) fixa o tempo decorrido, ainda limitado aos 600000 ms do contrato e correto com o millis() voltando a zero. Congelar antes da largada ou de novo não tem efeito; iniciar() e zerar() desfazem o congelamento. emAndamento() passa a indicar só a contagem ativa, e congelado() informa o congelamento.
2026-10-19 feat(firmware): adaptador do Cronometro para o ICronometro da parada (#41)
    O ICronometro do ParadaObjetivo não recebe o instante atual e o Cronometro não lê relógio, para continuar sem Arduino. O adaptador recebe uma função de tempo em ms (millis() no robô, relógio falso nos testes) e chama congelar(agoraMs).
2026-10-19 feat(frimware): implementação do envio de estatus acada 1s
2026-10-19 docs(firmware): registra mapeamento para TRAVADO e pontos de integracao da navegacao (HU-06)
2026-10-19 feat(frontend): adiciona filtragem de historico por geometria e data (HU-13) (#51)
    - Cria servico puro historicoFiltros.js com suporte a filtro por geometria e datas
    - Implementa testes unitarios e benchmark de 500+ registros atendendo RNF-SFT04
    - Atualiza componente HistoricoCorridas com visual de tabela conforme prototipo
    - Mantem retrocompatibilidade com modo compacto no Painel
2026-10-20 refactor(firmware): remove envio e conversão duplicados da telemetria (#43)
    O envio por ESP-NOW (RadioTelemetria, canal 1 e broadcast), o pacote de 18 bytes (TelemetriaPacket) e a conversão para JSON no gateway (TelemetriaJson.h) já existem na main desde o #159. As cópias em robo/src/telemetria e gateway/src/Conversor redefiniam o TelemetriaPacket, usavam canal 0 e o MAC do gateway e geravam um JSON fora do contrato. A leitura da bateria (sensores/Bateria) é mantida e adaptada no próximo commit.
2026-10-20 feat(firmware): leitura da bateria pelo divisor no GPIO 34 com conversão pura (#43)
    Aproveita a leitura do commit bedab4b, separada em duas partes. BateriaConversao.h, sem Arduino, converte os milivolts do ADC em milivolts da bateria pelo divisor de 100 kΩ e 33 kΩ do doc 4.3 e calcula a porcentagem na mesma faixa do simulador do backend (7,0 V a 8,4 V). Bateria.h e .cpp só leem o GPIO 34 com analogReadMilliVolts (atenuação de 11 dB), com a média de 16 leituras para suavizar o ruído do ADC, e passam a ter o pino como constante própria em vez de Pinos.h e Config.h, que não existem no repositório.
2026-10-20 feat(firmware): velocidade média da prova pelas células andadas e pelo cronômetro (#43)
    Células andadas x 180 mm dividido pelo tempo da prova, em mm/s, arredondado e limitado ao int16_t do campo do pacote; 0 antes da largada. A conta é feita em 64 bits para não estourar.
2026-10-20 feat(firmware): bateria e velocidade média no pacote de telemetria (#43)
    A cada envio a 1 Hz o pacote passa a levar a tensão e a porcentagem da bateria e a velocidade média calculada com os deslocamentos do Navegador e o tempo do cronômetro (congelada junto com ele na chegada). A velocidade atual fica em 0 até existirem os encoders.
2026-10-20 test(firmware): conversão da bateria e velocidade média (#43)
2026-10-21 docs(backend): comandos do PowerShell sem precisar ativar o ambiente virtual
    Os exemplos usavam uvicorn, pytest e python direto, que só funcionam com o .venv ativado; no PowerShell isso dá "O termo 'uvicorn' não é reconhecido", e o Activate.ps1 costuma ser bloqueado pela política de execução. Os blocos de PowerShell passam a chamar .\.venv\Scripts\python -m ...; os de Linux e macOS continuam com o ambiente ativado.
2026-10-21 feat(frontend): adiciona inspecao e replay temporal de corrida passada (HU-14) (#52)
2026-10-21 feat(firmware): adiciona deteccao de travamento e corte de motores em <= 1.2s (HU-18) (#59)
2026-10-21 docs(#144): evidências dos testes de software (cobertura, CI e painel com o simulador)
    Prints dos relatórios de cobertura do firmware, do backend e do frontend, das execuções de CI na main e do painel com o simulador nas três geometrias, nos cenários completa e travado. Medido em 21/10/2026 sobre o commit 60a364a.
2026-10-21 docs(#144): relatório 7.4 de testes de software
    HUs implementadas e protótipos, associação entre HUs, casos de teste e testes automatizados, cobertura medida das três partes, estrutura dos testes E2E (pendentes, #143), validação de ponta a ponta com o simulador, roteiro de testes atualizado e casos que ficam para a AP18.
2026-10-22 feat(#33): controle de curvas de 90 graus com IMU e encoders (HU-02)
2026-10-22 test(#33): testes nativos do controle de curvas e simulação de 24 curvas seguidas
2026-10-22 docs(#33): registra o controle de curvas no doc 4.4
2026-10-22 fix(firmware): monitora travamento por roda individual e remove includes do main (HU-18) (#59)
    - Monitora os pulsos de cada roda separadamente (esquerda e direita)
    - Garante deteccao mesmo se apenas uma das rodas for bloqueada
    - Adiciona documentacao de calibracao da zona morta dos motores
    - Remove includes desnecessarios em main.cpp (deixando para a integracao)
2026-10-25 ci: job de testes E2E com Playwright no workflow do frontend (#143)
2026-10-25 test(frontend): registra o início de cada tentativa no E2E do recomeço do mapa (#143)
2026-10-25 docs(#144): atualiza as evidências dos testes de software (cobertura, CI, E2E e painel com o simulador)
2026-10-25 docs(#138): relatorio 7.3 de testes de hardware e suite de ensaios laboratoriais
2026-10-26 docs: relatório 7.2 de testes de energia (#133)
    Consumo de corrente dos motores (parados, em movimento e em stall), simulação no KiCad x bancada, descarga contínua, autonomia e comportamento térmico, com as figuras dos ensaios e a matriz de rastreabilidade dos requisitos de energia.
2026-10-26 docs(#144): incorpora evidências e protótipos ao relatório 7.4 e usa links absolutos para a entrega em PDF
2026-10-26 docs(#144): esclarece na introdução que a correção dos testes E2E (#177) veio depois da medição
2026-10-26 feat: imagens de cada peça do carrinho
2026-10-26 docs: tabela de teste e validações reformulado
2026-10-26 docs(hardware): integra evidencias dos ensaios de calibracao e enlace ESP-NOW
    - Adiciona analise e graficos de calibracao polinomial dos sensores ToF VL53L0X
    - Adiciona evidencias fotograficas da montagem fisica e leitura serial em bancada
    - Incorpora ensaio experimental de campo do enlace ESP-NOW a 8 metros
    - Documenta analise de perda de ACK no Canal 3 e justificativa da fixacao no Canal 1
    - Inclui scripts de geracao de PDF da documentacao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
2026-10-28 docs(#130): atualiza projeto conceitual de energia
2026-11-01 test: estabiliza a persistencia de corridas
2026-11-01 test: isola banco do teste de corridas
2026-11-01 fix: atualização do banco e conserto de falhas de banco com telemetria
2026-11-04 fix(backend): renomeia migracao sql para armazena.sql
2026-11-04 feat(historico): integra filtragem de corridas com persistência e API (HU-13) (#51)
    - Adiciona suporte a parâmetros de consulta (geometria, data, data_inicio, data_fim) em GET /api/corridas no backend
    - Implementa testes de filtragem e benchmark de performance para 500 registros atendendo ao RNF-SFT04 (< 2s)
    - Estende corridasApi.js com construirUrlCorridas e suporte a filtros na listagem
    - Atualiza HistoricoCorridas.jsx para formatar dados reais persistidos (tempo total, modo, tentativa, células)
    - Adiciona testes de renderização com formato real do banco e atualiza doc 7.4
2026-11-04 fix(historico): otimiza desempenho da listagem, integra filtros à API e reverte doc 7.4
    - Ajusta listarCorridas para não carregar leituras em lote, postergando via obterCorrida sob demanda ao inspecionar
    - Integra filtros do componente HistoricoCorridas ao painel para disparar consultas filtradas à API
    - Corrige teste test_perda_de_telemetria_finaliza_corrida_ativa usando aguardar_corridas para evitar timeout e IndexError no CI
    - Reverte alterações no relatório 7.4 entregue na AP12
2026-11-04 docs(hardware): atualiza arquitetura retroativamente com ESP32 no robo e ESP8266 no PC server
    - Atualiza o Projeto Conceitual de Hardware (doc 4.3) e os Testes de Hardware (doc 7.3) como fonte de verdade
    - Especifica o microcontrolador ESP32 DevKit V1 no robo e o ESP8266 para o gateway de bancada/servidor do PC
    - Corrige dados de projeto (divisor resistivo 100k/47k no GPIO 34 e BOM atualizada)
    - Atualiza a tabela de pinagem com o resumo de conexao do enlace sem fio e gateway
    - Adiciona suporte e compatibilidade para compilar o firmware do gateway no ESP8266 (platformio.ini e main.cpp)
2026-11-04 feat(hardware): adiciona firmware final homologado com testes graduais e telemetria ESP-NOW
    - Adiciona firmware de producao em hw/firm com mapeamento final sem conflitos
    - Integra driver da ponte H TB6612FNG (20 kHz PWM e freio ativo)
    - Integra odometria por interrupcao com encoders em quadratura
    - Integra gerenciador dos 3 sensores ToF VL53L0X com enderecamento I2C dinamico via XSHUT
    - Implementa console interativo com menu de testes graduais (sensores, motores, encoders, curvas e anti-colisao)
    - Integra transmissao de telemetria ESP-NOW (18 bytes) no Canal 1 compativel com o Gateway ESP8266 e frontend
    - Adiciona suite de testes unitarios em C++ e 5 exemplos isolados de bancada
2026-11-04 feat(firmware): centraliza pinos e constantes físicas do robô em hardware/Pinos.h (#149)
    Adota a pinagem do firmware da Eletrônica (hw/firm/include/pinout.h), que é a
    que está gravada no robô: ponte H, encoders, XSHUT dos três ToF, I2C, botão,
    LED de estado e bateria. O LED de estado passa do GPIO 2 (agora canal B do
    encoder direito) para o GPIO 14, provisoriamente, até a Eletrônica confirmar.
    Constantes físicas confirmadas: roda de 32 mm, 360 pulsos por volta e bitola
    de 80 mm. O ControleReta e o ControleCurva passam a usar o mm por pulso
    calculado (cerca de 0,279 mm) e a bitola de 80 mm no lugar dos valores
    provisórios (0,1 mm e 78 mm).
    Acrescenta o test_pinos, que garante qu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
2026-11-04 fix(firmware): usa o divisor 5:1 da bateria do firmware da Eletrônica (#43)
    A conversão da bateria assumia 100 kΩ / 33 kΩ. O firmware que roda no robô usa
    o módulo sensor de tensão de 30 kΩ / 7,5 kΩ (proporção 5:1): a bateria cheia
    de 8,4 V dá 1,68 V no pino. Os resistores passam a ficar em hardware/Pinos.h,
    e os testes da bateria foram refeitos para essa proporção. A faixa de
    porcentagem (7,0 a 8,4 V) continua a mesma.
    O doc 4.3 indica 100 kΩ / 47 kΩ; a Eletrônica precisa confirmar qual divisor
    está montado.
2026-11-07 ci: compila o firmware de bancada da Eletrônica no Firmware CI (#139)
    O hw/firm usa a biblioteca de telemetria do Software (src/firmware/lib/telemetria)
    pelo lib_extra_dirs, mas o Firmware CI só compilava o robo e o gateway: uma
    mudança no contrato podia quebrar o firmware de bancada sem ninguém perceber.
    Acrescenta hw/firm/** aos paths do workflow e um job firmware-bancada que só
    compila o hw/firm para o ESP32 (sem testes nativos nem cobertura), com cache
    próprio do PlatformIO. Os jobs do robo e do gateway não mudam.
2026-11-09 fix(backend): grava a orientação com o nome do contrato e alinha banco.py ao armazena.sql (#142)
    O MySQL recusava toda leitura porque a orientação era gravada abreviada
    (N, S, L, O) numa coluna ENUM('NORTE','SUL','LESTE','OESTE'). As conversões
    ORIENTACAO_BANCO e ORIENTACAO_TELEMETRIA foram removidas e o banco.py passa a
    descrever exatamente o armazena.sql: ENUMs, TINYINT, SMALLINT, DATETIME(6),
    padrões no servidor e nomes de índices e FK. Os índices de labirinto e
    status_final entram no armazena.sql.
    Os testes de persistência rodam no SQLite e, com MYSQL_TEST_URL, também no
    MySQL; test_banco_mysql.py compara o mapeamento com o schema refletido. A API
    REST passa a responder com CO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
2026-11-09 ci(backend): roda os testes de persistência contra MySQL com o armazena.sql (#142)
    Novo job "Persistência no MySQL" no Backend CI: sobe o mysql:8.0, aplica
    migrations/armazena.sql e roda os testes marcados com mysql.
2026-11-09 test(frontend): mede o histórico com 500 corridas no E2E e registra a evidência do RNF-SFT04 (#142)
    O spec historico-desempenho popula 500 corridas, filtra o histórico no painel e
    verifica TTFB, resposta da API e atualização da tabela abaixo de 2 s. A
    evidência gerada contra o MySQL fica em docs/evidencias/5.1.2.1.
    Com o histórico carregando de verdade, os E2E passaram a ver o labirinto do
    replay: os seletores ficam restritos ao mapa ao vivo e cada backend do E2E grava
    num SQLite próprio.
2026-11-09 feat(backend): simulador mantém o sinal após o fim e a perda_conexao retoma os pacotes (#44)
    Como o robô real, a fonte do simulador continua transmitindo a última mensagem
    depois de CONCLUIDO ou TRAVADO, inclusive na pausa entre corridas, para o painel
    não avisar perda de RF com o robô parado.
    O cenário perda_conexao passa a perder 4 pacotes seguidos no meio do percurso e
    termina em CONCLUIDO: o robô não depende do rádio. A fonte transforma a lacuna em
    4 s de silêncio de relógio, entre os 3 s do aviso no painel e os 5 s de
    TELEMETRIA_TIMEOUT_S, independente do fator de velocidade.
    As repetições do pacote terminal (mesmo status e timestamp) não são mais gravadas
    como leitura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
2026-11-09 docs(evidencias): registra os prints e as medições da HU-09 em 5.1.1.2 (#44)
    O E2E da HU-09 salva os prints e as medições em docs/evidencias/5.1.1.2 com
    E2E_EVIDENCIAS=1, sem alterar a pasta 5.3.2.1 da AP12. A fixture evidencia
    aceita a pasta de destino e grava o mesmo print anexado ao relatório.
2026-11-09 fix(frontend): move o histórico geral para uma seção de largura total (#65)
    Na coluna da direita, o histórico geral não cabia: em 1366x768 a página rolava
    na horizontal (1406 px de conteúdo), o mapa do replay passava da borda do cartão
    e a tabela de 9 colunas precisava de rolagem interna nas duas resoluções. Os
    filtros, a tabela e o replay passam a ficar numa seção abaixo do mapa e dos
    indicadores; o histórico compacto da sessão continua na coluna.
2026-11-09 docs(evidencias): registra os prints do layout desktop em 5.1.1.3 (#65)
    Prints de cada navegador e resolução, antes e depois da correção, com README
    no padrão das outras pastas.
2026-11-09 feat(telemetria): adiciona script run.sh para inicializar backend e frontend unificados
2026-11-09 feat(telemetria): adiciona script de monitoramento continuo do websocket
2026-11-09 fix(firmware): explicita pinMode(INPUT) para o GPIO 34 da bateria
2026-11-10 test(frontend): move as verificações de layout para e2e/layout.js (#66)
    COMPONENTES e procurarDistorcoes saem do layout-desktop.spec.js para serem usados também pelo teste de celular. procurarDistorcoes ganha a opção rolagemPermitida; o teste de desktop continua com as mesmas verificações.
2026-11-10 feat(frontend): painel em uma coluna no celular, com os indicadores antes do mapa (#66)
    Abaixo de 768 px: layout em coluna, sem as larguras mínimas maiores que a tela (500, 320 e 340 px), recuos menores nos cartões e a barra de tempo do replay podendo encolher. A tabela do histórico geral rola dentro do próprio cartão.
2026-11-10 test(frontend): testa o layout no celular em 360x640 e 412x915 nas três geometrias (#66)
    Projetos chromium-360x640 e chromium-412x915 com emulação de celular. O teste confere rolagem horizontal, status, cronômetro e telemetria inteiros na tela, fonte de pelo menos 14 px nos valores e os limites dos componentes.
2026-11-10 docs(evidencias): registra os prints do layout móvel em 5.1.1.4 (#66)
2026-11-11 test(firmware): move o SimuladorLabirinto para test/comum (HU-06) (#149)
    Sem mudança no simulador; só o include do test_navegador muda. Permite que outros testes, como o do executor e o futuro robô virtual, usem o mesmo simulador (achado R12). Refs #39
2026-11-11 refactor(firmware): orientação de grade só no Navegador, ControleCurva controla só o ângulo (HU-02) (#149)
    Remove enum Orientacao, definirOrientacao(), orientacao(), a tabela de giro e o parâmetro inicial do construtor, que mantinham uma segunda cópia da orientação capaz de divergir da do Navegador numa curva abortada (achado B1 de docs/firmware/integracao-loop.md). Acrescenta sentido() para o executor repassar ao Navegador em confirmarGiro(). Os testes de orientação passam a conferir a conclusão e o sentido; a orientação já é coberta por test_direcao e test_navegador. Refs #33
2026-11-11 feat(firmware): tração por roda no detector e no monitor de travamento (HU-18) (#149)
    Sobrecargas de verificar() com tração por roda e tracaoEsqAtiva()/tracaoDirAtiva() em IFonteTracao com implementação padrão que repete tracaoAtiva(). Uma roda sem comando não é dada como travada. As assinaturas atuais continuam valendo (achado R1). Refs #59
2026-11-11 refactor(firmware): passo da célula e vão do corredor em hardware/Pinos.h (HU-08) (#149)
    CELULA_MM = 180 (centro a centro, regulamento) e VAO_CORREDOR_MM = 168. VelocidadeMedia mantém TAMANHO_CELULA_MM como apelido de CELULA_MM. O test_controle deixa de declarar cópias locais das duas medidas, que agora colidiriam com Pinos.h (achado R2). Refs #43, #32
2026-11-11 docs(#149): troca as tarefas FreeRTOS pelo laço cooperativo nas seções 4.1 e 4.3 do doc 4.4
    Ritmos, ordem dentro do tick e a justificativa da troca (melhoria M5 de docs/firmware/integracao-loop.md). Ajusta também a linha de conclusão do controle de curvas na seção 5.2, que ainda citava a orientação interna removida no B1.
2026-11-11 feat(firmware): constantes de montagem, PWM, ToF, parede, LED e bateria em hardware/Pinos.h (#149)
    Inversões de motores e encoders (R7), PWM da ponte H e da conversão de velocidade (B6), endereços, validade e tempos dos ToF (B10), limiar e histerese de parede (R3), tipo do LED de estado (R5) e tensão mínima de largada (R4). O comentário de ENCODER_PULSOS_POR_VOLTA passa a dizer que o valor é a confirmar na bancada (B4). Valores iniciais do hw/firm e do desenho em docs/firmware/integracao-loop.md.
2026-11-11 feat(firmware): odometria pelos encoders com instante do último pulso por roda (HU-18) (#149)
    Contagens em mm, velocidade em janela de 200 ms, rumo odométrico e alvo em pulsos derivado de Pinos.h (B4). Registra quando cada contagem mudou e implementa IFontePulsos para o MonitorTravamento sem tocar na interrupção (R6). Refs #59, #43
2026-11-11 feat(firmware): validade das leituras ToF e classificador de paredes com histerese (HU-06) (#149)
    LeituraToF invalida o sensor sem amostra nova há 100 ms (B10) e marca amostra nova para o controle de reta. ClassificadorParedes concentra o limiar com histerese e implementa SensoresParedes para o Navegador (R3); sem alvo ao alcance (8190 mm) é ausência de parede. Refs #39
2026-11-11 feat(firmware): conversão de velocidade em PWM com zona morta e saturação (HU-01, HU-02) (#149)
    Malha aberta, |PWM| = PWM_MINIMO + |v| x PWM_POR_MM_S, sem nunca emitir PWM dentro da zona morta (B6). Valores provisórios em Pinos.h, a calibrar na rampa de PWM. Refs #32, #33
2026-11-11 feat(firmware): motores com trinco de parada, tração por roda e inversão de montagem (HU-18, HU-07) (#149)
    Lógica pura sobre a interface IPonteH, testada no nativo. parar() freia e trava os comandos até liberar() na próxima largada, para o controle não desfazer o corte do MonitorTravamento ou do ParadaObjetivo (B7). Implementa IFonteTracao com tração por roda (R1) e aplica as inversões de Pinos.h (R7). Refs #59
2026-11-11 feat(firmware): padrões do LED de estado para WS2812B e LED comum (HU-05) (#149)
    Cores iguais às do main.cpp atual no WS2812B e ritmos de piscada distintos por estado no LED comum, sem delay (R5). Refs #38
2026-11-11 feat(firmware): tensão mínima da bateria para aceitar a largada (HU-05, HU-08) (#149)
    bateriaPermiteLargada() compara com BATERIA_MINIMA_LARGADA_MV (6800 mV, o alarme do hw/firm). O uso na largada entra no CicloProva da etapa 5 (R4). Refs #38, #43
2026-11-11 feat(firmware): drivers da ponte H, encoders, ToF sem espera e LED de estado (#149)
    Porte dos drivers do hw/firm para src/drivers com os pinos de hardware/Pinos.h, sem alterar hw/. PonteHTb6612 implementa IPonteH; Encoders conta pulsos na interrupção com as inversões de montagem (R7); SensoresToF consulta amostra pronta em vez de esperar o sensor, com timeout de I2C de 5 ms e espera de 50 ms após erro (B10); SinalizacaoLed implementa ISinalizacaoEstado nas duas variantes (R5). Acrescenta pololu/VL53L0X ao ambiente esp32dev. O main.cpp ainda não usa os drivers: o laço novo é a etapa 5.
2026-11-11 docs(firmware): registra as decisões da etapa 4 e a pendência dos GPIO 36 e 39 (#149)
    Divisão dos motores em lógica e ponte H, arquivos puros novos na tabela de módulos, leitura sem alvo como ausência de parede, proteção contra erro de I2C, modelo do conversor e o efeito dos valores provisórios, e a errata do ESP32 sobre os GPIO 36 e 39 com o ADC ligado, com a conferência no roteiro de bancada.
2026-11-11 fix(firmware): limita o PWM de movimento a 90, como no hw/firm, até a rampa de PWM (HU-01, HU-02) (#149)
    PWM_MAXIMO_MOVIMENTO = 90 é o teto padrão do conversor; os 255 da ponte H ficam só para o freio ativo. A inclinação passa de 0,6 para (90 - 40) / 150, cerca de 0,33, para os 150 mm/s da reta caírem em PWM 90: com 0,6 e o teto em 90, a faixa inteira da reta saturaria nas duas rodas e o controle perderia a correção lateral. O teste da faixa da reta é trocado por testes do teto, da base da reta e da correção com o teto. O comentário dos encoders registra que a contagem 1x é a do hw/firm, usada nas medições. Refs #32, #33
2026-11-11 docs(firmware): valores do hw/firm como ponto de partida, teto de PWM 90 no roteiro e mitigação dos GPIO 36 e 39 na etapa 5 (#149)
2026-11-11 fix(firmware): roda que volta a ser acionada recomeça o tempo sem pulso no detector de travamento (HU-18) (#149)
    Com a tração por roda, a carência usava o instante em que a tração geral ligou: uma roda parada de propósito que voltasse a ser comandada com a outra já girando era dada como travada no primeiro tick. Cada roda passa a guardar o próprio instante de acionamento, e o tempo sem pulso de uma roda sem comando fica em 0. A sobrecarga com tração única se comporta como antes. Inclui o teste sugerido na revisão do PR #198 e um que confere o corte 1 s depois da reativação. Refs #59
2026-11-11 test(firmware): sentido() só vale com a curva concluída e teste de curva abortada (HU-02) (#149)
    Documenta no cabeçalho que sentido() só vale com CURVA_CONCLUIDA. O teste de conclusão passa a usar SENTIDO_DIREITA, que não é o valor inicial. Teste novo de curva abortada: CURVA_FALHOU não vira concluída nem quando o robô chega ao alvo depois. O teste da sequência de curvas confere o rumo ideal interno pelo erro da curva seguinte, e não a variável local. Revisão do PR #198. Refs #33
2026-11-11 refactor(firmware): motivo de falha informado pelo executor e recusa sem efeito colateral (HU-06) (#149)
    Remove o resultado_ sem efeito do ExecutorImediato e o FALHA_PEDIDO_INVALIDO: iniciarGiro()/iniciarAvanco() recusados só devolvem false e não sobrescrevem o motivo de uma falha ainda não lida. Interface opcional InformanteMotivoFalha para o executor bloqueante informar o motivo, o que torna COLISAO e TRAVADO testáveis no nativo. Dublê ExecutorTemporizado em test/comum, que devolve MOV_EM_ANDAMENTO por alguns ciclos, exercita o laço de espera de verdade. O desenho passa a usar os nomes do enum (FALHA_EMERGENCIA_FRONTAL, FALHA_TRACAO_CORTADA, FALHA_TEMPO). Revisão do PR #198. Refs #3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
2026-11-11 feat(firmware): interfaces de hardware do laço e drivers ligados a elas, com pausa do encoder esquerdo (HU-18) (#149)
    app/InterfacesHardware.h reúne o que o laço e o executor usam do hardware: botão, encoders, ToF, bateria, rádio, LED e registro. Encoders, SensoresToF e SinalizacaoLed passam a implementá-las. Encoders ganha pausarEsquerdo()/retomarEsquerdo() (gpio_intr_disable no GPIO 36), a mitigação da errata dos GPIO 36 e 39 com o ADC ligado (pendência 9 do desenho). SinalizacaoLed ganha piscadas de aviso por relógio, sem delay() (R8), e LeituraToF expõe o instante da última amostra. Refs #59
2026-11-11 feat(firmware): executor de giros e avanços sem bloqueio sobre os controles de reta e curva (HU-01, HU-02, HU-06) (#149)
    ExecutorMovimentoRobo implementa a interface não bloqueante sobre ControleCurva, ControleReta, Odometria, ConversorVelocidadePwm e Motores. Parâmetros do hw/firm: 3 s no avanço, 2 s por curva, freio, 200 ms de assentamento e roda livre; alvo do avanço de 180 mm em pulsos. Curva relativa sem IMU (B5), reta só com amostra nova dos laterais (R11), encosto e emergência frontal, e fim imediato com o trinco fechado (B7). DIST_MINIMA_SEGURA_MM e DIST_ENCOSTO_FRONTAL_MM em Pinos.h. Testes sobre uma bancada simulada. Refs #32, #33, #39
2026-11-11 feat(firmware): laço da prova com estados, falhas, telemetria completa e nova tentativa (HU-05, HU-06, HU-07, HU-08, HU-18) (#149)
    CicloProva roda um tick por volta do loop(): entradas, segurança a 50 ms, máquina da prova com o executor a 10 ms, telemetria a 1 Hz e LED. Largada com recusa por bateria baixa (R4), chegada só pelo ParadaObjetivo (B2), TIMEOUT aos 10 min (B8), COLISAO e TRAVADO conforme a seção 3.7, desafio_cumprido e velocidade_atual preenchidos (B9), volta a AGUARDANDO depois de um estado terminal (R9) e bateria lida com o encoder esquerdo pausado. Testes no nativo sobre o SimuladorLabirinto, nas três geometrias. Refs #38, #39, #41, #43, #59
2026-11-11 feat(firmware): main.cpp liga os drivers ao laço da prova, sem delay() (#149)
    O main.cpp só cria os drivers, os invólucros de botão, bateria, rádio e log, monta o CicloProva e chama tick(millis()) em todo loop(). Imprime a cada 5 s o maior tempo de tick, para o relatório 7.5 (M4, R8, R10).
2026-11-11 docs(#149): estados finais voltam a AGUARDANDO, árvore do firmware e bitola de 80 mm no doc 4.4
    Diagrama de estados da seção 4.3 com a volta a AGUARDANDO (R9), árvore de diretórios da seção 4.4 como está no repositório (o main.cpp não cria tarefas), bitola de 80 mm na seção 5.2, como em hardware/Pinos.h, e LED a 50 ms na tabela de ritmos. Pendências deixadas na etapa 3.
2026-11-11 docs(firmware): registra as decisões da etapa 5 no desenho da integração (#149)
    Parâmetros do executor vindos do hw/firm, curva de 2 s na tabela de falhas, nova tentativa de leitura no diagrama de subfases, LED a 50 ms, interfaces de hardware reais, mitigação dos GPIO 36 e 39 implementada e a linha de tempo de tick no roteiro de bancada.
2026-11-11 feat(hardware): sincronização ToF e encoders, odometria 22mm e controle remoto ESP-NOW
    - Atualiza diâmetro da roda para 22.0 mm (doc 4.1 seção 7.1) em hw/firm e src/firmware/robo
    - Implementa fusão sensorial ToF + Encoders com controle PD lateral a 50 Hz e modo monoparede
    - Adiciona rampa suave de aceleração e desaceleração para avanço e curvas de 90° e 180°
    - Implementa recepção de comandos remotos via ESP-NOW no robô e retransmissão no gateway
    - Cria utilitário scripts/controle_remoto.py para operação sem fio via terminal
    - Atualiza doc 4.3 com pinagem sem conflitos e arquitetura sensorial validada
2026-11-11 fix(test): sincroniza asserções de pulsos com roda de 22mm em test_odometria e test_executor
2026-11-11 fix(firmware): corrige quebra de linha em literal de string no printf do esp-now
